FranciscoVentures/EN7745/Hardware/CHANGES.TXT

Multiple Hardware Security Elements

– NXP Semiconductors ; EdgeLock SE050 , A1006,  AT71CH 

– Infineon OPTIGA™ TRUST SLS32AIA

- Coral AI

- Microphones

- Physical Sensors
