FranciscoVentures/EN7745/Hardware/Curiosity.kicad_pcb

## KiCad design Hardware/Curiosity.kicad_pcb (2021-01-01)

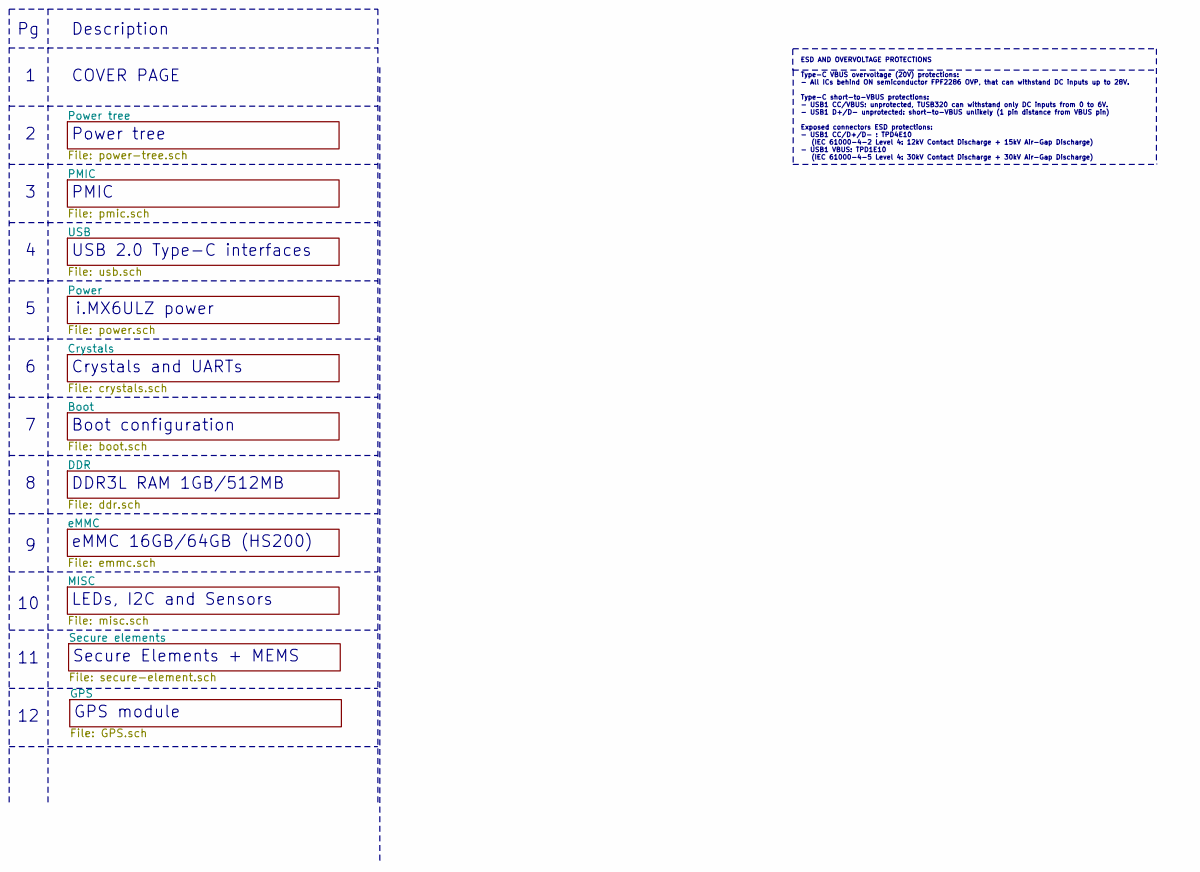
[picture p1: schematic Curiosity.sch]

Notes on the sheet:
DDR3L RAM 1GB/512MB
eMMC 16GB/64GB (HS200)
Secure Elements + MEMS
GPS module
Boot configuration
i.MX6ULZ power
USB 2.0 Type-C interfaces
Crystals and UARTs
ESD AND OVERVOLTAGE PROTECTIONS Type-C VBUS overvoltage (20V) protections: - All ICs behind ON semiconductor FPF2286 OVP, that can withstand DC inputs up to 28V. Type-C short-to-VBUS protections: - USB1 CC/VBUS: unprotected, TUSB320 can withstand only DC inputs from 0 to 6V. - USB1 D+/D- unprotecte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
PMIC
Description
Power tree
COVER PAGE
LEDs, I2C and Sensors

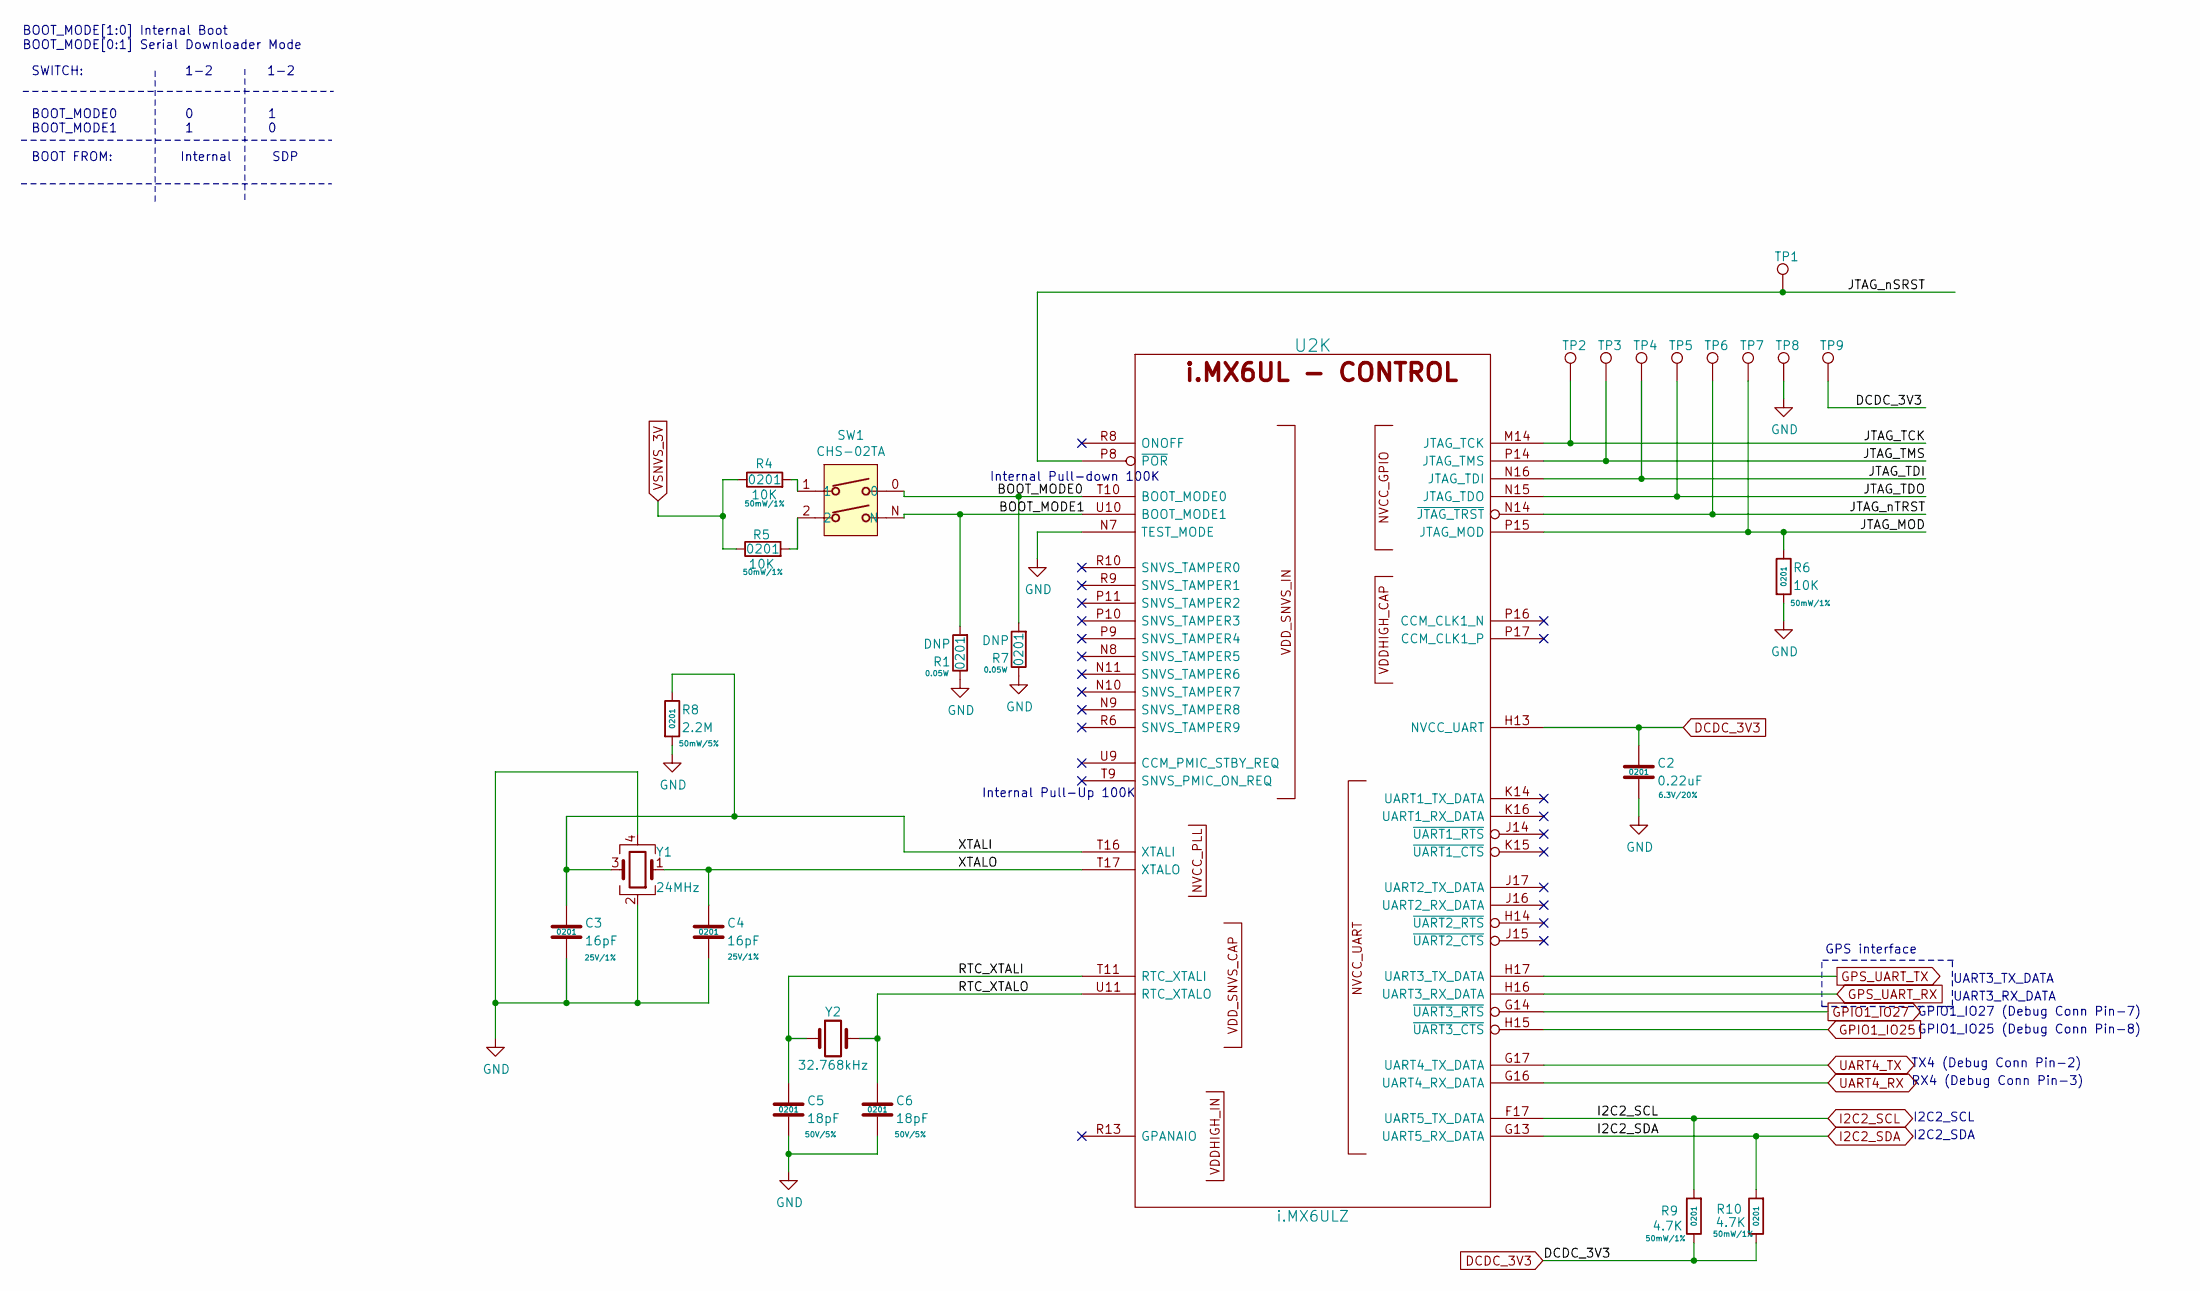
[picture p2: schematic crystals.sch]

Parts:
C2: 0.22uF; SM0201; Rating 6.3V/20%; Mfg PN GRM033R60J224ME15D; Digi-Key_PN 490-10407-1-ND
C3, C4: 16pF; SM0201; Rating 25V/1%; Mfg PN CBR02C160F3GAC; Digi-Key_PN 399-8574-1-ND
C5, C6: 18pF; SM0201; Rating 50V/5%; Mfg PN GRM0335C1H180JA01D; Digi-Key_PN 490-6117-1-ND
R1, R7: DNP; R_0201_0603Metric; Rating 0.05W; Mfg PN CRCW02010000Z0ED; Digi-Key_PN 541-0.0AGCT-ND
R4, R5, R6: 10K; R_0201_0603Metric; Rating 50mW/1%; Mfg PN CRCW020110K0JNED; Digi-Key_PN 541-10KAGCT-ND
R8: 2.2M; R_0201_0603Metric; Rating 50mW/5%; Mfg PN RC0201JR-072M2L; Digi-Key_PN YAG2882CT-ND
R9, R10: 4.7K; R_0201_0603Metric; Rating 50mW/1%; Mfg PN CRCW02014K70JNED; Digi-Key_PN 541-4.7KAGCT-ND
SW1: CHS-02TA; Mfg PN CHS-02TA; Digi-Key_PN 563-1005-2-ND
TP1, TP2, TP3, TP4, TP5, TP6, TP7, TP8, TP9: TestPoint; TP
U2: i.MX6ULZ; SOT1534-2; Mfg PN MCIMX6Z0DVM09AB; Digi-Key_PN 568-14726-ND
Y1: 24MHz; TSX-3225; Mfg PN TSX-3225 24.0000MF15X-AC3; Digi-Key_PN SER3635TR-ND
Y2: 32.768kHz; CM7V-T1A; Mfg PN CM7V-T1A-32.768KHZ-12.5PF-20PPM-TB-QA; Digi-Key_PN 2195-CM7V-T1A-32.768KHZ-12.5PF-20PPM-TB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

Connections:
/Crystals/BOOT_MODE0: R7.2, SW1.0, U2.T10 (BOOT_MODE0); also elsewhere on the board
/Crystals/BOOT_MODE1: R1.2, SW1.N, U2.U10 (BOOT_MODE1); also elsewhere on the board
/Crystals/JTAG_MOD: R6.1, TP7.1, U2.P15 (JTAG_MOD); also elsewhere on the board
/Crystals/JTAG_TCK: TP2.1, U2.M14 (JTAG_TCK); also elsewhere on the board
/Crystals/JTAG_TDI: TP4.1, U2.N16 (JTAG_TDI); also elsewhere on the board
/Crystals/JTAG_TDO: TP5.1, U2.N15 (JTAG_TDO); also elsewhere on the board
/Crystals/JTAG_TMS: TP3.1, U2.P14 (JTAG_TMS); also elsewhere on the board
/Crystals/JTAG_nSRST: TP1.1, U2.P8 (~POR); also elsewhere on the board
/Crystals/JTAG_nTRST: TP6.1, U2.N14 (~JTAG_TRST); also elsewhere on the board
/Crystals/RTC_XTALI: C5.1, U2.T11 (RTC_XTALI), Y2.1; also elsewhere on the board
/Crystals/RTC_XTALO: C6.1, U2.U11 (RTC_XTALO), Y2.2; also elsewhere on the board
/Crystals/XTALI: C3.1, R8.1, U2.T16 (XTALI), Y1.3; also elsewhere on the board
/Crystals/XTALO: C4.1, U2.T17 (XTALO), Y1.1; also elsewhere on the board
DCDC_3V3: C2.1, R9.1, R10.1, TP9.1, U2.H13 (NVCC_UART); also elsewhere on the board
GND: C2.2, C3.2, C4.2, C5.2, C6.2, R1.1, R6.2, R7.1, R8.2, TP8.1, U2.N7 (TEST_MODE), Y1.2, Y1.4; also elsewhere on the board
GPIO1_IO25: U2.H15 (~UART3_CTS); also elsewhere on the board
GPIO1_IO27: U2.G14 (~UART3_RTS); also elsewhere on the board
GPS_UART_RX: U2.H16 (UART3_RX_DATA); also elsewhere on the board
GPS_UART_TX: U2.H17 (UART3_TX_DATA); also elsewhere on the board
I2C2_SCL: R9.2, U2.F17 (UART5_TX_DATA); also elsewhere on the board
I2C2_SDA: R10.2, U2.G13 (UART5_RX_DATA); also elsewhere on the board
unnamed: R4.2, SW1.1
unnamed: R5.2, SW1.2
unnamed 209: U2.H14 (~UART2_RTS); also elsewhere on the board
unnamed 211: U2.J14 (~UART1_RTS); also elsewhere on the board
unnamed 212: U2.J15 (~UART2_CTS); also elsewhere on the board
unnamed 213: U2.J16 (UART2_RX_DATA); also elsewhere on the board
unnamed 214: U2.J17 (UART2_TX_DATA); also elsewhere on the board
unnamed 215: U2.K14 (UART1_TX_DATA); also elsewhere on the board
unnamed 216: U2.K15 (~UART1_CTS); also elsewhere on the board
unnamed 217: U2.K16 (UART1_RX_DATA); also elsewhere on the board
unnamed 218: U2.N8 (SNVS_TAMPER5); also elsewhere on the board
unnamed 219: U2.N9 (SNVS_TAMPER8); also elsewhere on the board
unnamed 220: U2.N10 (SNVS_TAMPER7); also elsewhere on the board
unnamed 221: U2.N11 (SNVS_TAMPER6); also elsewhere on the board
unnamed 222: U2.P9 (SNVS_TAMPER4); also elsewhere on the board
unnamed 223: U2.P10 (SNVS_TAMPER3); also elsewhere on the board
unnamed 224: U2.P11 (SNVS_TAMPER2); also elsewhere on the board
unnamed 225: U2.P16 (CCM_CLK1_N); also elsewhere on the board
unnamed 226: U2.P17 (CCM_CLK1_P); also elsewhere on the board
unnamed 227: U2.R6 (SNVS_TAMPER9); also elsewhere on the board
unnamed 228: U2.R8 (ONOFF); also elsewhere on the board
unnamed 229: U2.R9 (SNVS_TAMPER1); also elsewhere on the board
unnamed 230: U2.R10 (SNVS_TAMPER0); also elsewhere on the board
unnamed 231: U2.R13 (GPANAIO); also elsewhere on the board
unnamed 232: U2.T9 (SNVS_PMIC_ON_REQ); also elsewhere on the board
unnamed 234: U2.U9 (CCM_PMIC_STBY_REQ); also elsewhere on the board
UART4_RX: U2.G16 (UART4_RX_DATA); also elsewhere on the board
UART4_TX: U2.G17 (UART4_TX_DATA); also elsewhere on the board
VSNVS_3V: R4.1, R5.1; also elsewhere on the board

Notes on the sheet:
BOOT_MODE[1:0] Internal Boot BOOT_MODE[0:1] Serial Downloader Mode
GPS interface
UART3_TX_DATA
UART3_RX_DATA
SWITCH: 1-2 1-2 BOOT_MODE0 0 1 BOOT_MODE1 1 0 BOOT FROM: Internal SDP
GPIO1_IO27 (Debug Conn Pin-7)
RX4 (Debug Conn Pin-3)
TX4 (Debug Conn Pin-2)
I2C2_SDA
I2C2_SCL
Internal Pull-down 100K
Internal Pull-Up 100K
GPIO1_IO25 (Debug Conn Pin-8)

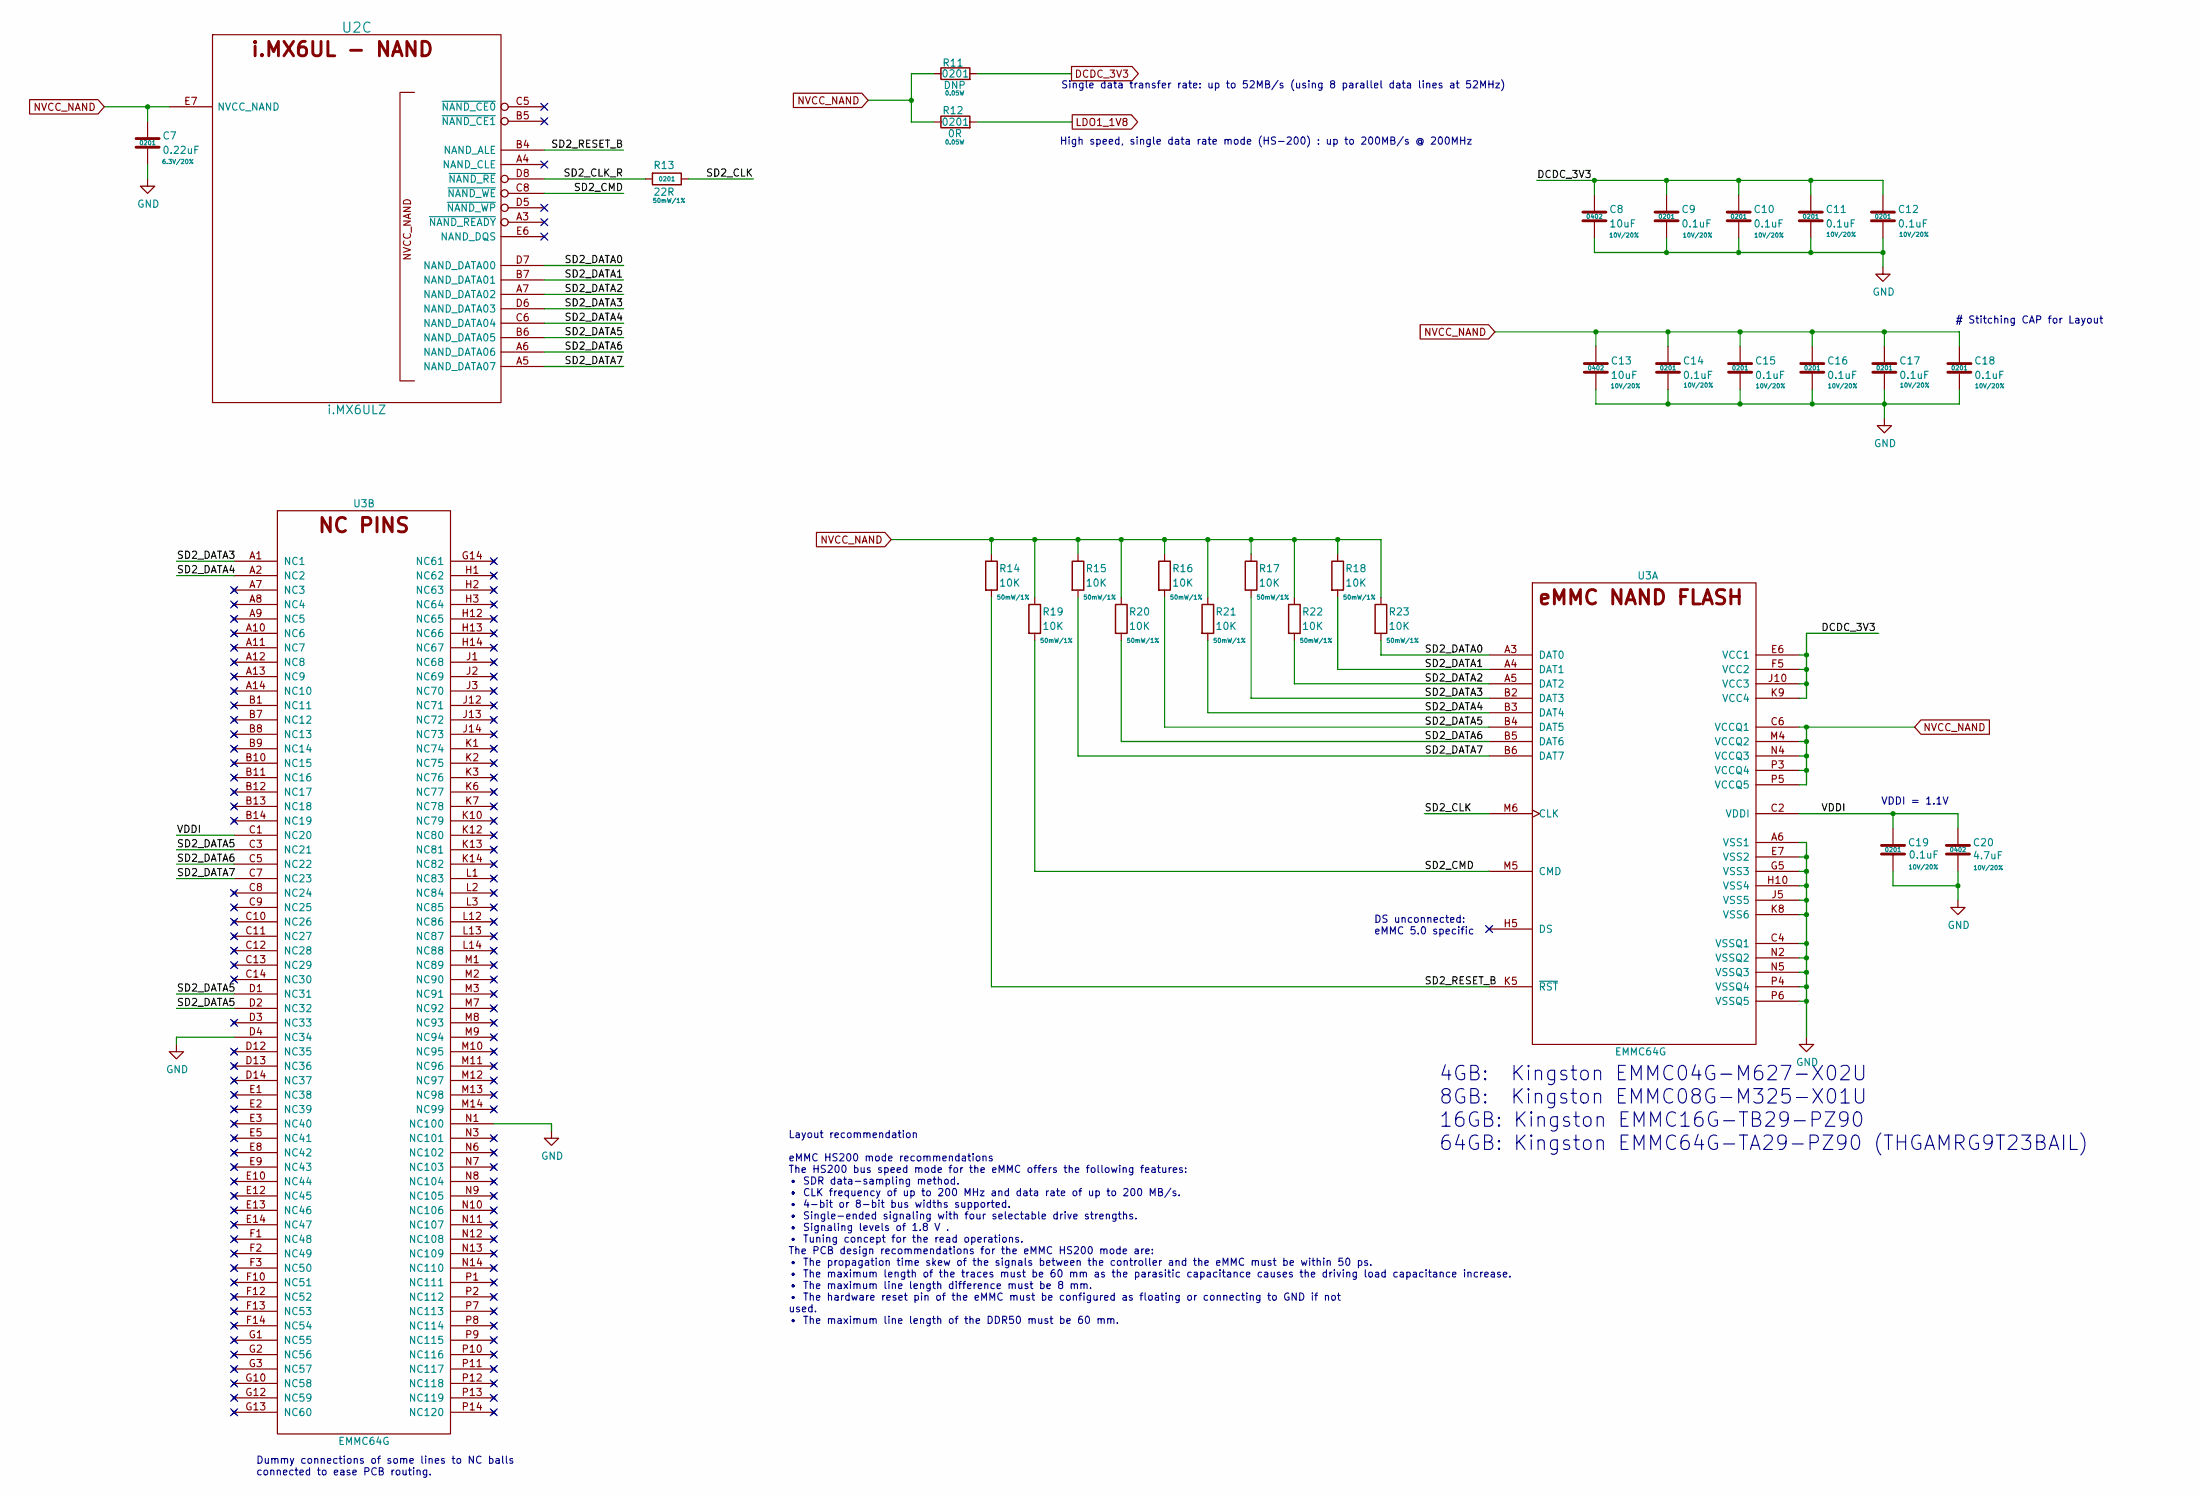
[picture p3: schematic emmc.sch]

Parts:
C7: 0.22uF; SM0201; Rating 6.3V/20%; Mfg PN GRM033R60J224ME15D; Digi-Key_PN 490-10407-1-ND
C8, C13: 10uF; SM0402; Rating 10V/20%; Mfg PN CL05A106MP8NUB8; Digi-Key_PN 1276-6830-1-ND
C9, C10, C11, C12, C14, C15, C16, C17, C18, C19: 0.1uF; SM0201; Rating 10V/20%; Mfg PN GRM033R61A104ME15D; Digi-Key_PN 490-5405-1-ND
C20: 4.7uF; SM0402; Rating 10V/20%; Mfg PN ZRB15XR61A475ME01D; Digi-Key_PN 490-10984-1-ND
R11: DNP; R_0201_0603Metric; Rating 0.05W; Mfg PN CRCW02010000Z0ED; Digi-Key_PN 541-0.0AGCT-ND
R12: 0R; R_0201_0603Metric; Rating 0.05W; Mfg PN CRCW02010000Z0ED; Digi-Key_PN 541-0.0AGCT-ND
R13: 22R; R_0201_0603Metric; Rating 50mW/1%; Mfg PN CRCW020122R0JNED; Digi-Key_PN 541-22AGCT-ND
R14, R15, R16, R17, R18, R19, R20, R21, R22, R23: 10K; R_0201_0603Metric; Rating 50mW/1%; Mfg PN CRCW020110K0JNED; Digi-Key_PN 541-10KAGCT-ND
U2: i.MX6ULZ; SOT1534-2; Mfg PN MCIMX6Z0DVM09AB; Digi-Key_PN 568-14726-ND
U3: EMMC64G; FBGA-153; Mfg PN THGAMRG9T23BAIL; Digi-Key_PN THGAMRG9T23BAIL-ND

Connections:
/eMMC/SD2_CLK: R13.1, U3.M6 (CLK)
/eMMC/SD2_CLK_R: R13.2, U2.D8 (~NAND_RE); also elsewhere on the board
/eMMC/SD2_CMD: R19.2, U2.C8 (~NAND_WE), U3.M5 (CMD); also elsewhere on the board
/eMMC/SD2_DATA0: R23.2, U2.D7 (NAND_DATA00), U3.A3 (DAT0); also elsewhere on the board
/eMMC/SD2_DATA1: R18.2, U2.B7 (NAND_DATA01), U3.A4 (DAT1); also elsewhere on the board
/eMMC/SD2_DATA2: R22.2, U2.A7 (NAND_DATA02), U3.A5 (DAT2); also elsewhere on the board
/eMMC/SD2_DATA3: R17.2, U2.D6 (NAND_DATA03), U3.A1 (NC1), U3.B2 (DAT3); also elsewhere on the board
/eMMC/SD2_DATA4: R21.2, U2.C6 (NAND_DATA04), U3.A2 (NC2), U3.B3 (DAT4); also elsewhere on the board
/eMMC/SD2_DATA5: R16.2, U2.B6 (NAND_DATA05), U3.B4 (DAT5), U3.C3 (NC21), U3.D1 (NC31), U3.D2 (NC32); also elsewhere on the board
/eMMC/SD2_DATA6: R20.2, U2.A6 (NAND_DATA06), U3.B5 (DAT6), U3.C5 (NC22); also elsewhere on the board
/eMMC/SD2_DATA7: R15.2, U2.A5 (NAND_DATA07), U3.B6 (DAT7), U3.C7 (NC23); also elsewhere on the board
/eMMC/SD2_RESET_B: R14.2, U2.B4 (NAND_ALE), U3.K5 (~RST); also elsewhere on the board
/eMMC/VDDI: C19.1, C20.1, U3.C1 (NC20), U3.C2 (VDDI)
DCDC_3V3: C8.1, C9.1, C10.1, C11.1, C12.1, R11.2, U3.E6 (VCC1), U3.F5 (VCC2), U3.J10 (VCC3), U3.K9 (VCC4); also elsewhere on the board
GND: C7.2, C8.2, C9.2, C10.2, C11.2, C12.2, C13.2, C14.2, C15.2, C16.2, C17.2, C18.2, C19.2, C20.2, U3.A6 (VSS1), U3.C4 (VSSQ1), U3.D4 (NC34), U3.E7 (VSS2), U3.G5 (VSS3), U3.H10 (VSS4), U3.J5 (VSS5), U3.K8 (VSS6), U3.N1 (NC100), U3.N2 (VSSQ2), U3.N5 (VSSQ3), U3.P4 (VSSQ4), U3.P6 (VSSQ5); also elsewhere on the board
LDO1_1V8: R12.2; also elsewhere on the board
NVCC_NAND: C7.1, C13.1, C14.1, C15.1, C16.1, C17.1, C18.1, R11.1, R12.1, R14.1, R15.1, R16.1, R17.1, R18.1, R19.1, R20.1, R21.1, R22.1, R23.1, U2.E7 (NVCC_NAND), U3.C6 (VCCQ1), U3.M4 (VCCQ2), U3.N4 (VCCQ3), U3.P3 (VCCQ4), U3.P5 (VCCQ5); also elsewhere on the board
unnamed 175: U2.A3 (~NAND_READY); also elsewhere on the board
unnamed 176: U2.A4 (NAND_CLE); also elsewhere on the board
unnamed 182: U2.B5 (~NAND_CE1); also elsewhere on the board
unnamed 187: U2.C5 (~NAND_CE0); also elsewhere on the board
unnamed 192: U2.D5 (~NAND_WP); also elsewhere on the board
unnamed 196: U2.E6 (NAND_DQS); also elsewhere on the board

Notes on the sheet:
Dummy connections of some lines to NC balls connected to ease PCB routing.
DS unconnected: eMMC 5.0 specific
4GB: Kingston EMMC04G-M627-X02U 8GB: Kingston EMMC08G-M325-X01U 16GB: Kingston EMMC16G-TB29-PZ90 64GB: Kingston EMMC64G-TA29-PZ90 (THGAMRG9T23BAIL)
# Stitching CAP for Layout
High speed, single data rate mode (HS-200) : up to 200MB/s @ 200MHz
Single data transfer rate: up to 52MB/s (using 8 parallel data lines at 52MHz)
Layout recommendation eMMC HS200 mode recommendations The HS200 bus speed mode for the eMMC offers the following features: • SDR data-sampling method. • CLK frequency of up to 200 MHz and data rate of up to 200 MB/s. • 4-bit or 8-bit bus widths supported. • Single-ended signaling with four selectab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
VDDI = 1.1V

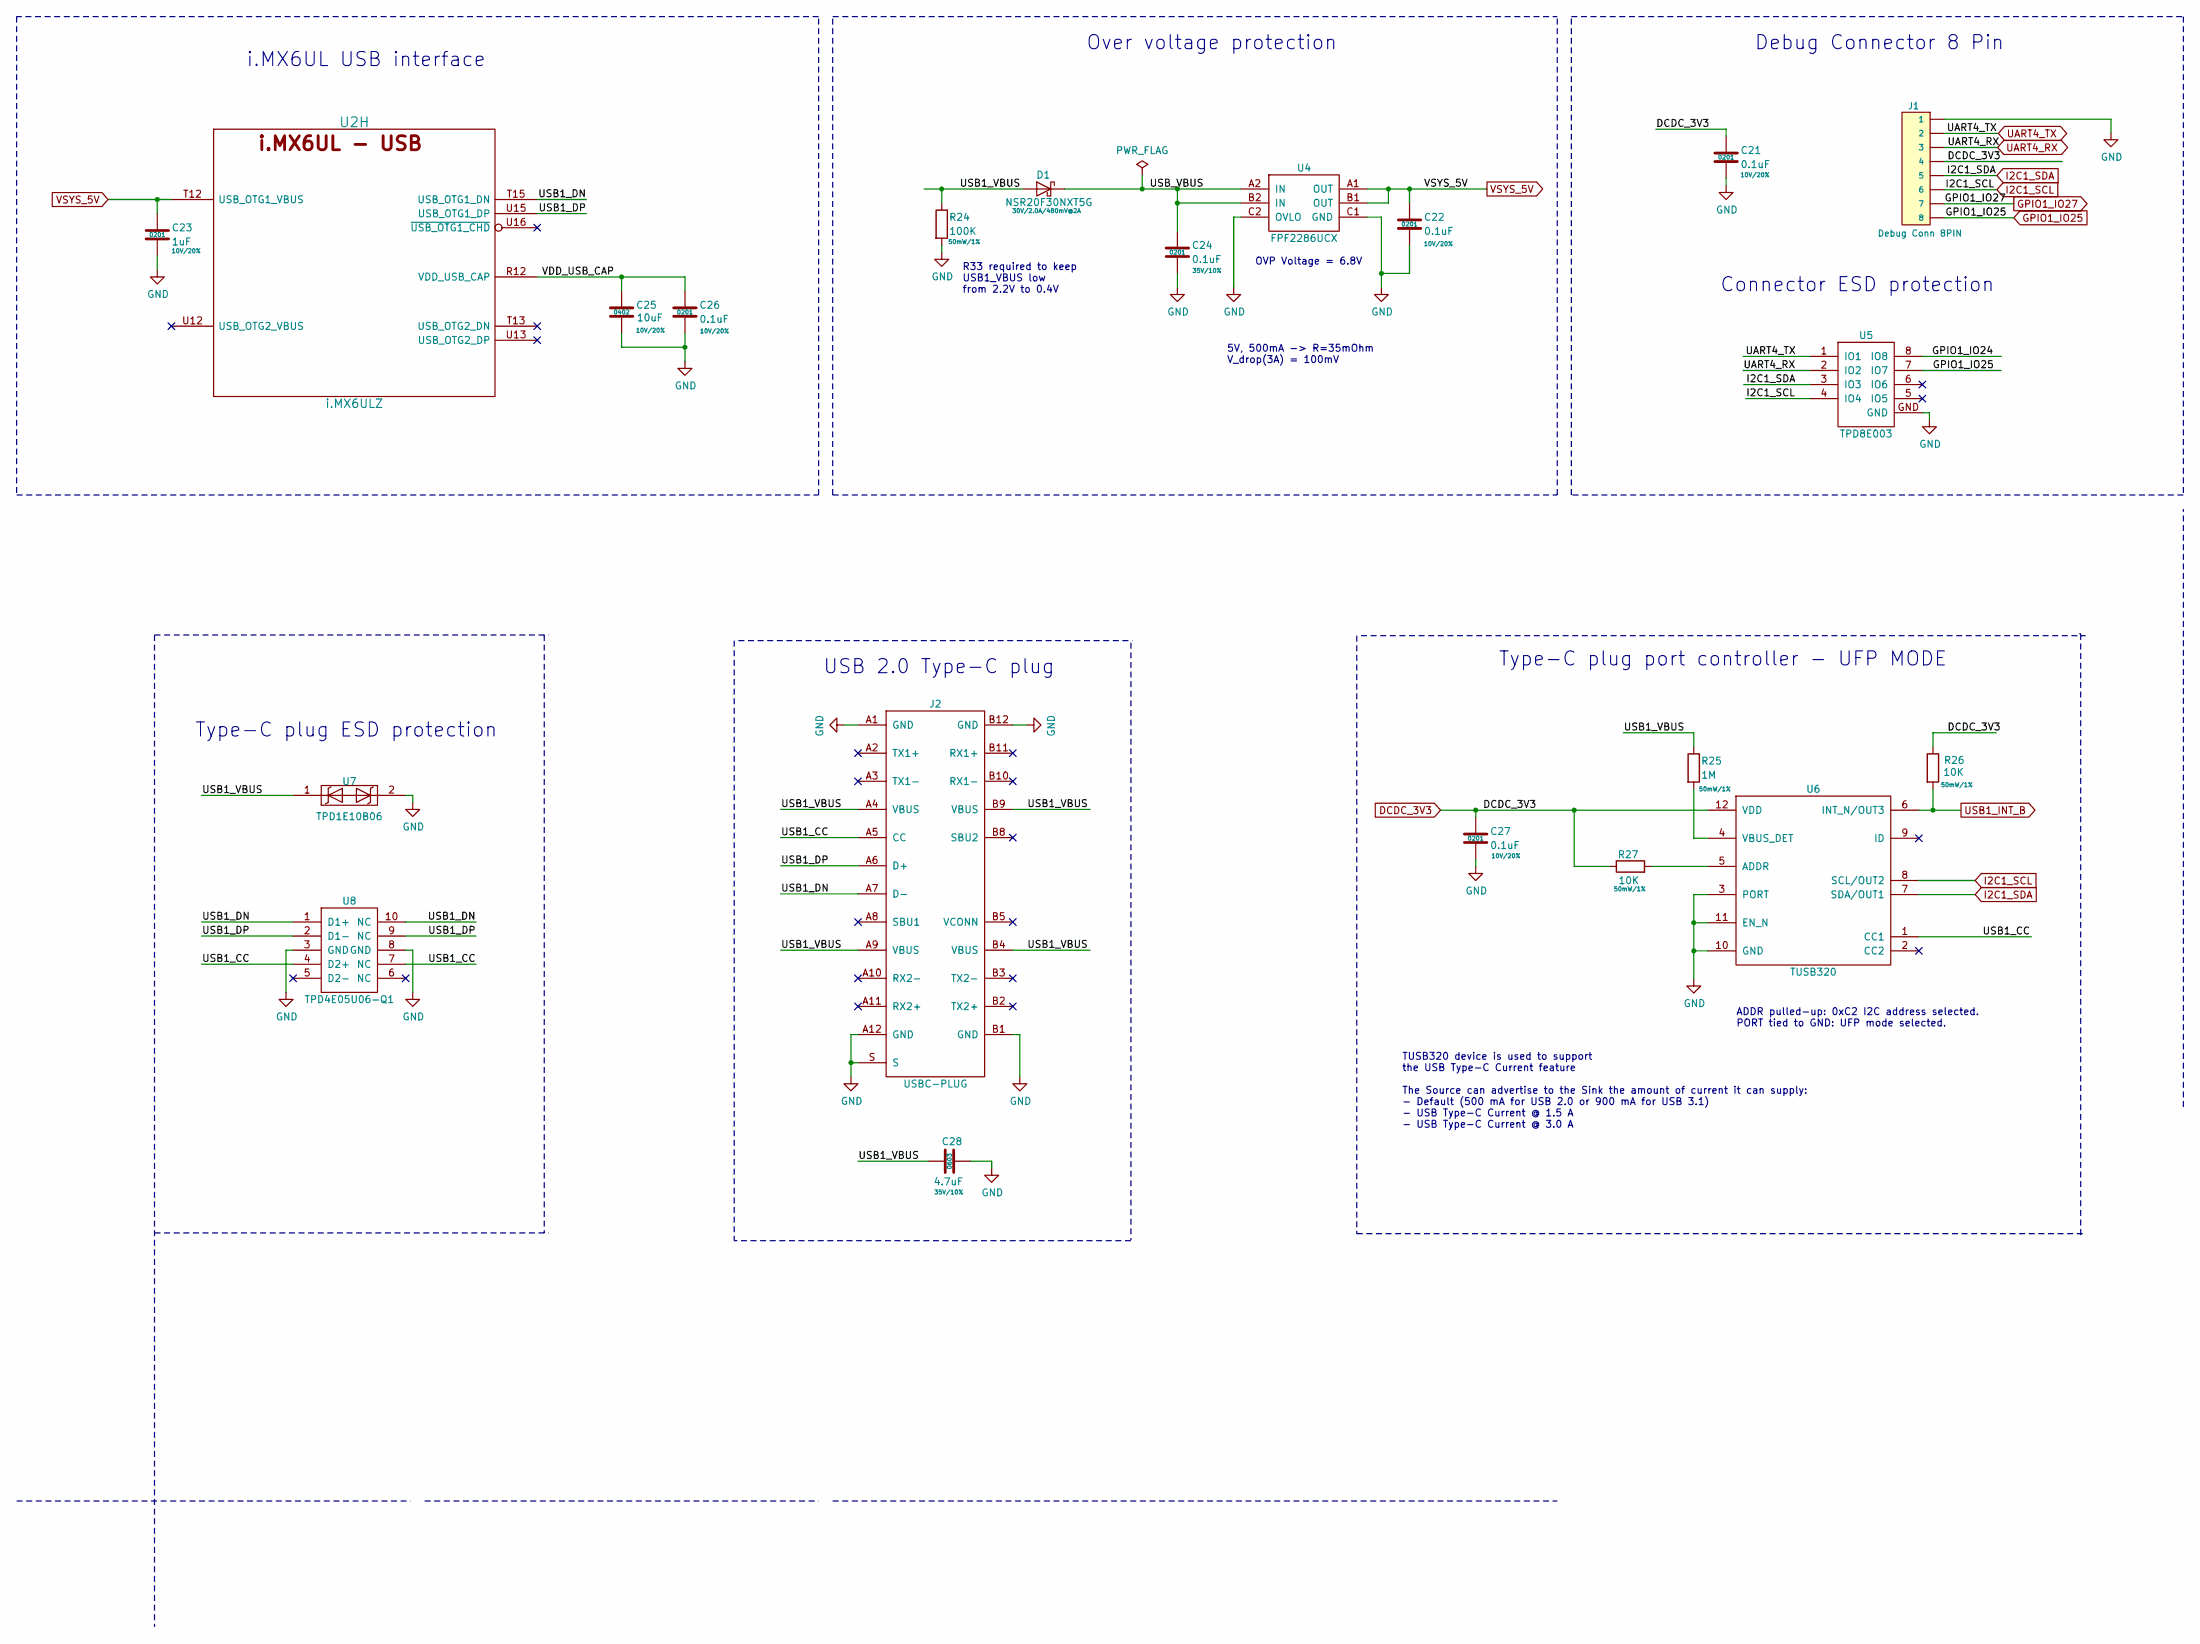
[picture p4: schematic usb.sch]

Parts:
C21, C22, C26, C27: 0.1uF; SM0201; Rating 10V/20%; Mfg PN GRM033R61A104ME15D; Digi-Key_PN 490-5405-1-ND
C23: 1uF; SM0201; Rating 10V/20%; Mfg PN CL03A105MP3ZSNH; Digi-Key_PN 1276-6816-1-ND
C24: 0.1uF; SM0201; Rating 35V/10%; Mfg PN GRM033R6YA104KE14D; Digi-Key_PN 490-10430-1-ND
C25: 10uF; SM0402; Rating 10V/20%; Mfg PN CL05A106MP8NUB8; Digi-Key_PN 1276-6830-1-ND
C28: 4.7uF; SM0603; Rating 35V/10%; Mfg PN GRM188R6YA475KE15D; Digi-Key_PN 490-7205-1-ND
D1: NSR20F30NXT5G; DSN2; Rating 30V/2.0A/480mV@2A; Mfg PN NSR20F30NXT5G; Digi-Key_PN NSR20F30NXT5GOSCT-ND
J1: Debug Conn 8PIN; BC075-08; Mfg PN BC075-08-A-L-A; Digi-Key_PN 2073-BC075-08-A-L-ACT-ND
J2: USBC-PLUG; WURTH_632712000011; Mfg PN 632712000011; Digi-Key_PN 732-9616-1-ND
R24: 100K; R_0201_0603Metric; Rating 50mW/1%; Mfg PN CRCW0201100KJNED; Digi-Key_PN 541-100KAGCT-ND
R25: 1M; R_0201_0603Metric; Rating 50mW/1%; Mfg PN CRCW02011M00FKED; Digi-Key_PN 541-1.00MAABCT-ND
R26, R27: 10K; R_0201_0603Metric; Rating 50mW/1%; Mfg PN CRCW020110K0JNED; Digi-Key_PN 541-10KAGCT-ND
U2: i.MX6ULZ; SOT1534-2; Mfg PN MCIMX6Z0DVM09AB; Digi-Key_PN 568-14726-ND
U4: FPF2286UCX; WLCSP-6; Mfg PN FPF2286UCX; Digi-Key_PN FPF2286UCXOSCT-ND
U5: TPD8E003; WSON-8; Mfg PN TPD8E003DQDR; Digi-Key_PN 296-27669-1-ND
U6: TUSB320; RWB-QFN-12; Mfg PN TUSB320IRWBR; Digi-Key_PN 296-42175-1-ND
U7: TPD1E10B06; X1SON-2; Mfg PN TPD1E10B06DPYR; Digi-Key_PN 296-30406-1-ND
U8: TPD4E05U06-Q1; DQA-USON-10; Mfg PN TPD4E05U06DQAR; Digi-Key_PN 296-35765-1-ND

Connections:
/USB/USB1_CC: J2.A5 (CC), U6.1 (CC1), U8.4 (D2+), U8.7 (NC)
/USB/USB1_DN: J2.A7 (D-), U2.T15 (USB_OTG1_DN), U8.1 (D1+), U8.10 (NC); also elsewhere on the board
/USB/USB1_DP: J2.A6 (D+), U2.U15 (USB_OTG1_DP), U8.2 (D1-), U8.9 (NC); also elsewhere on the board
/USB/USB1_VBUS: C28.1, D1.2 (A), J2.A4 (VBUS), J2.A9 (VBUS), J2.B4 (VBUS), J2.B9 (VBUS), R24.1, R25.1, U7.1
/USB/USB_VBUS: C24.1, D1.1 (K), U4.A2 (IN), U4.B2 (IN)
/USB/VDD_USB_CAP: C25.1, C26.1, U2.R12 (VDD_USB_CAP); also elsewhere on the board
DCDC_3V3: C21.1, C27.1, J1.4, R26.1, R27.1, U6.12 (VDD); also elsewhere on the board
GND: C21.2, C22.2, C23.2, C24.2, C25.2, C26.2, C27.2, C28.2, J1.1, J2.A1 (GND), J2.A12 (GND), J2.B1 (GND), J2.B12 (GND), J2.S, R24.2, U4.C1 (GND), U4.C2 (OVLO), U5.GND, U6.3 (PORT), U6.10 (GND), U6.11 (EN_N), U7.2, U8.3 (GND), U8.8 (GND); also elsewhere on the board
GPIO1_IO25: J1.8, U5.7 (IO7); also elsewhere on the board
GPIO1_IO27: J1.7; also elsewhere on the board
I2C1_SCL: J1.6, U5.4 (IO4), U6.8 (SCL/OUT2); also elsewhere on the board
I2C1_SDA: J1.5, U5.3 (IO3), U6.7 (SDA/OUT1); also elsewhere on the board
unnamed: R25.2, U6.4 (VBUS_DET)
unnamed: R27.2, U6.5 (ADDR)
unnamed 233: U2.T13 (USB_OTG2_DN); also elsewhere on the board
unnamed 235: U2.U12 (USB_OTG2_VBUS); also elsewhere on the board
unnamed 236: U2.U13 (USB_OTG2_DP); also elsewhere on the board
unnamed 237: U2.U16 (~USB_OTG1_CHD); also elsewhere on the board
UART4_RX: J1.3, U5.2 (IO2); also elsewhere on the board
UART4_TX: J1.2, U5.1 (IO1); also elsewhere on the board
USB1_INT_B: R26.2, U6.6 (INT_N/OUT3); also elsewhere on the board
VSYS_5V: C22.1, C23.1, U2.T12 (USB_OTG1_VBUS), U4.A1 (OUT), U4.B1 (OUT); also elsewhere on the board

Notes on the sheet:
ADDR pulled-up: 0xC2 I2C address selected. PORT tied to GND: UFP mode selected.
TUSB320 device is used to support the USB Type-C Current feature The Source can advertise to the Sink the amount of current it can supply: - Default (500 mA for USB 2.0 or 900 mA for USB 3.1) - USB Type-C Current @ 1.5 A - USB Type-C Current @ 3.0 A
USB 2.0 Type-C plug
Type-C plug ESD protection
Connector ESD protection
Type-C plug port controller - UFP MODE
OVP Voltage = 6.8V
5V, 500mA -> R=35mOhm V_drop(3A) = 100mV
Over voltage protection
i.MX6UL USB interface
R33 required to keep USB1_VBUS low from 2.2V to 0.4V
Debug Connector 8 Pin
