FranciscoVentures/EN7745/Hardware/Curiosity.kicad_pcb

## KiCad design Hardware/Curiosity.kicad_pcb (continued)

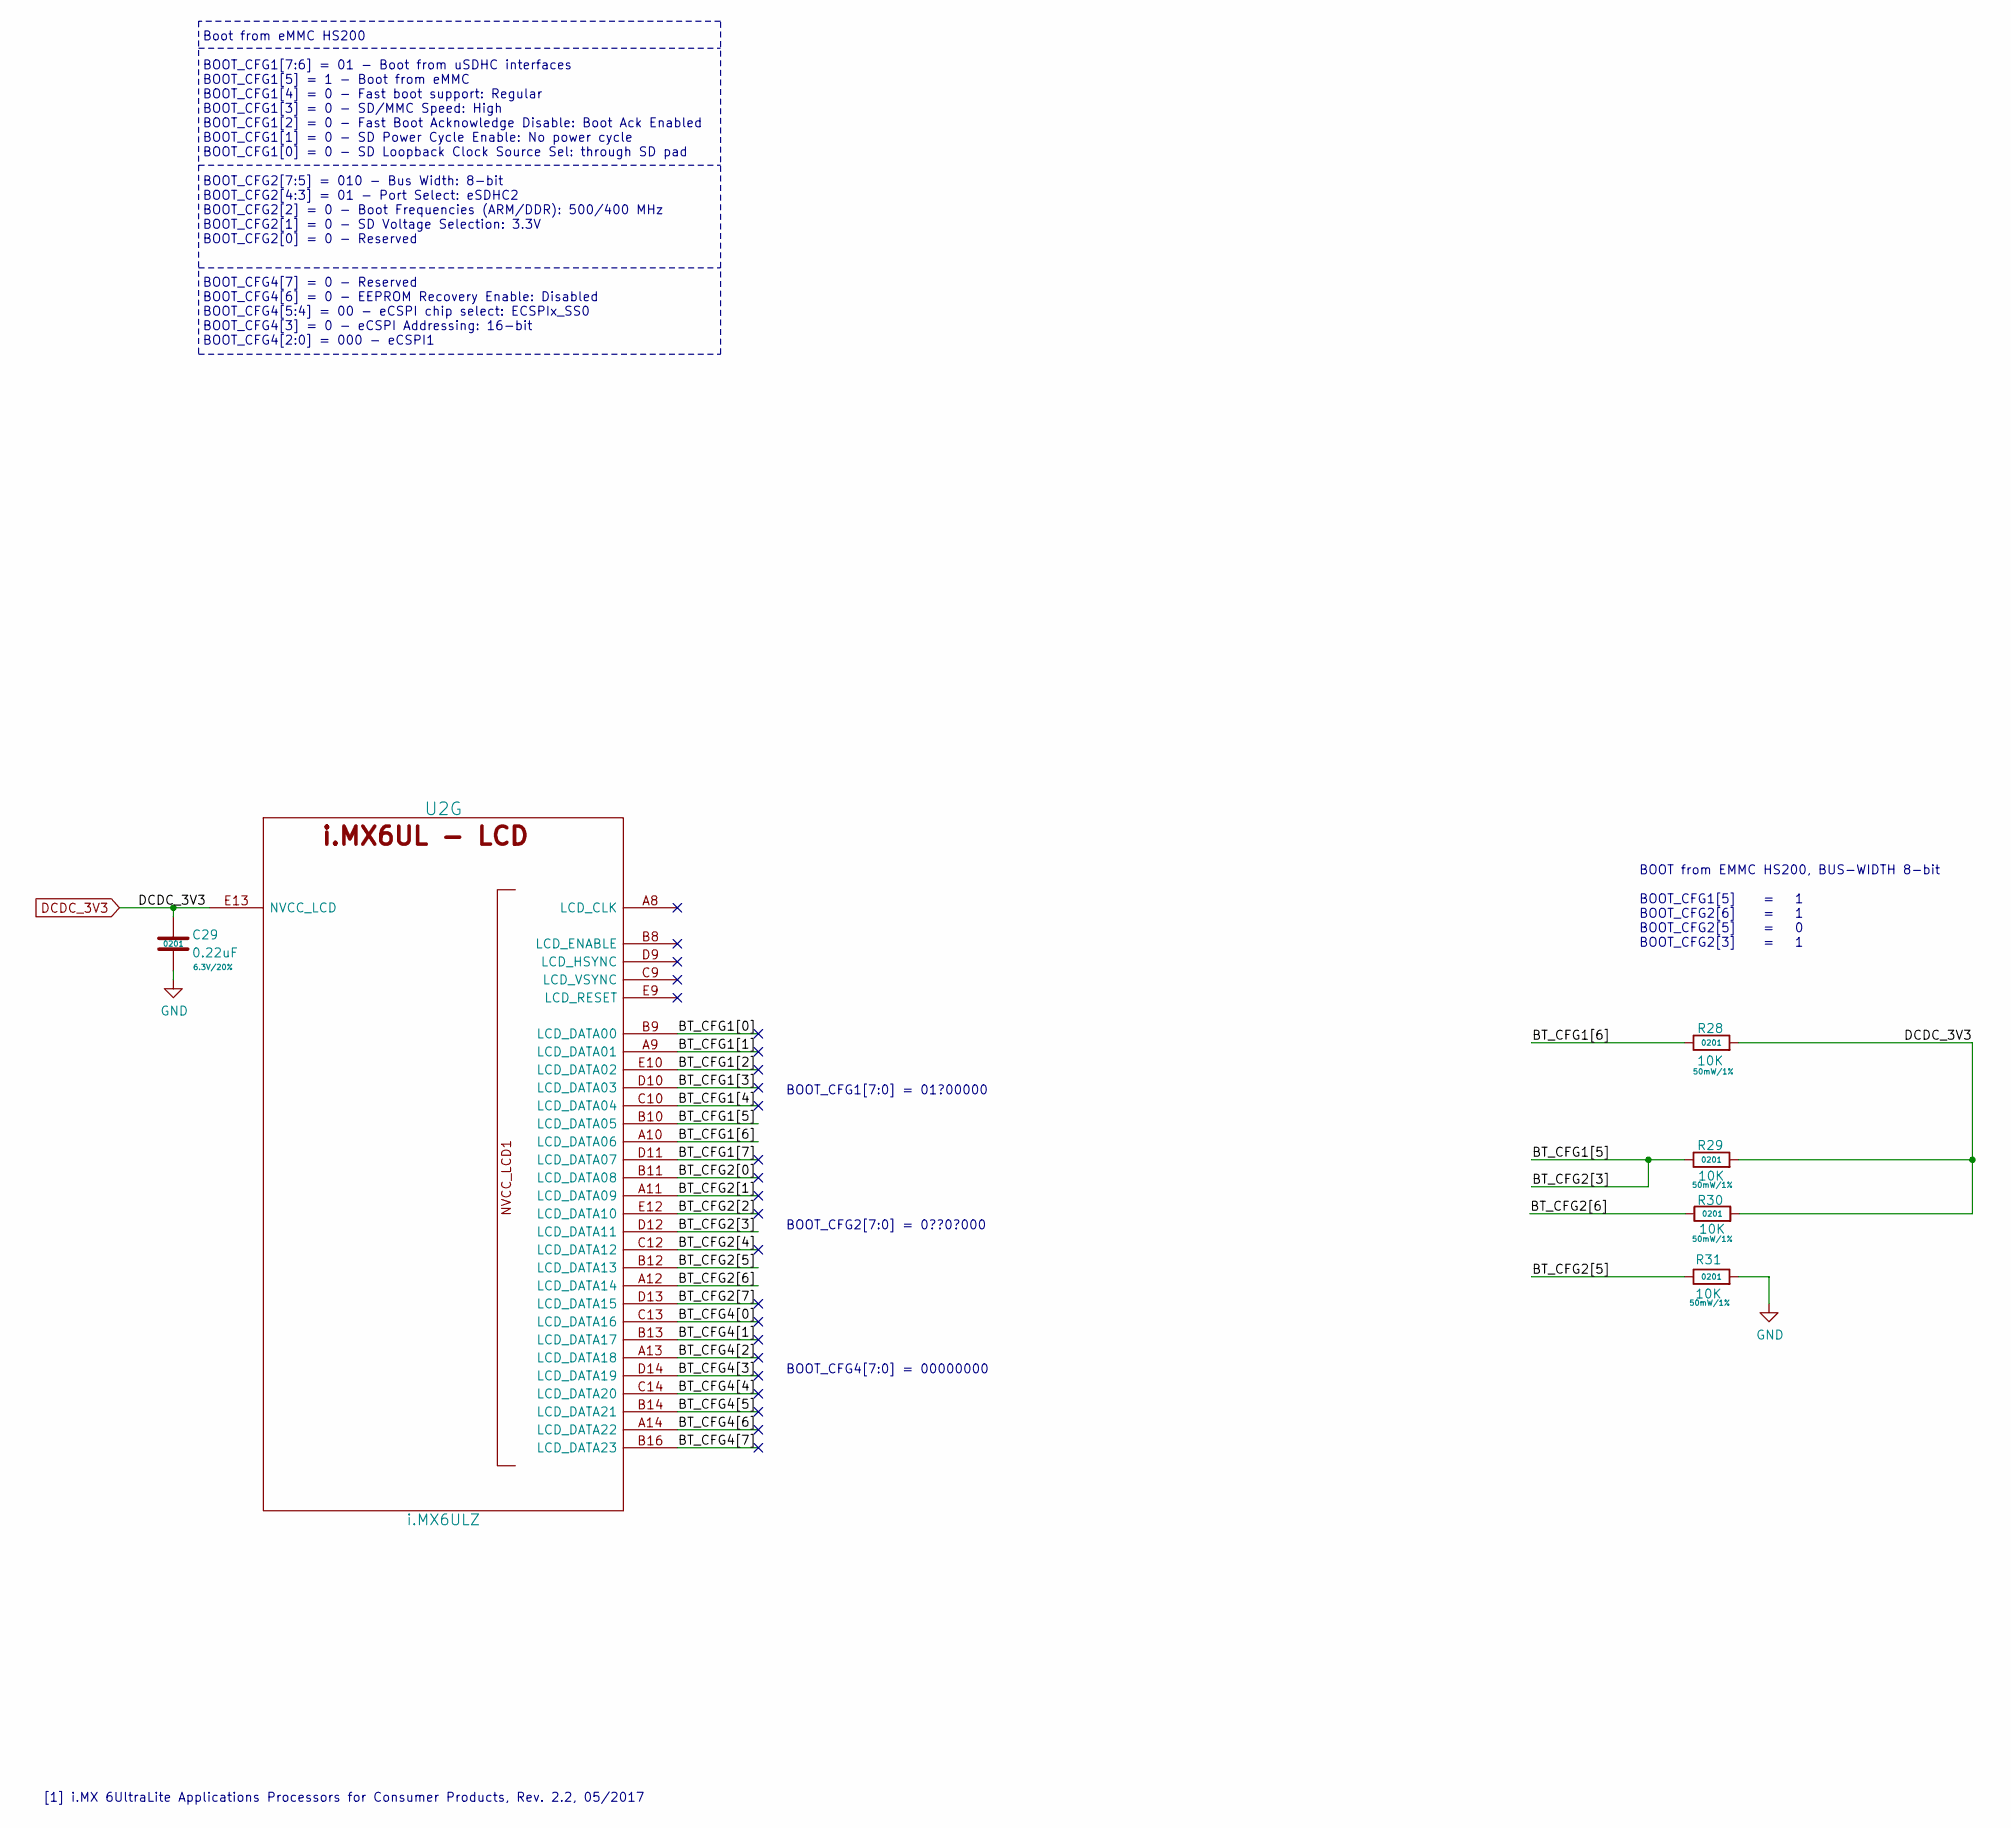
[picture p5: schematic boot.sch]

Parts:
C29: 0.22uF; SM0201; Rating 6.3V/20%; Mfg PN GRM033R60J224ME15D; Digi-Key_PN 490-10407-1-ND
R28, R29, R30, R31: 10K; R_0201_0603Metric; Rating 50mW/1%; Mfg PN CRCW020110K0JNED; Digi-Key_PN 541-10KAGCT-ND
U2: i.MX6ULZ; SOT1534-2; Mfg PN MCIMX6Z0DVM09AB; Digi-Key_PN 568-14726-ND

Connections:
/Boot/BT_CFG1[0]: U2.B9 (LCD_DATA00); also elsewhere on the board
/Boot/BT_CFG1[1]: U2.A9 (LCD_DATA01); also elsewhere on the board
/Boot/BT_CFG1[2]: U2.E10 (LCD_DATA02); also elsewhere on the board
/Boot/BT_CFG1[3]: U2.D10 (LCD_DATA03); also elsewhere on the board
/Boot/BT_CFG1[4]: U2.C10 (LCD_DATA04); also elsewhere on the board
/Boot/BT_CFG1[5]: R29.1, U2.B10 (LCD_DATA05), U2.D12 (LCD_DATA11); also elsewhere on the board
/Boot/BT_CFG1[6]: R28.1, U2.A10 (LCD_DATA06); also elsewhere on the board
/Boot/BT_CFG1[7]: U2.D11 (LCD_DATA07); also elsewhere on the board
/Boot/BT_CFG2[0]: U2.B11 (LCD_DATA08); also elsewhere on the board
/Boot/BT_CFG2[1]: U2.A11 (LCD_DATA09); also elsewhere on the board
/Boot/BT_CFG2[2]: U2.E12 (LCD_DATA10); also elsewhere on the board
/Boot/BT_CFG2[4]: U2.C12 (LCD_DATA12); also elsewhere on the board
/Boot/BT_CFG2[5]: R31.1, U2.B12 (LCD_DATA13); also elsewhere on the board
/Boot/BT_CFG2[6]: R30.1, U2.A12 (LCD_DATA14); also elsewhere on the board
/Boot/BT_CFG2[7]: U2.D13 (LCD_DATA15); also elsewhere on the board
/Boot/BT_CFG4[0]: U2.C13 (LCD_DATA16); also elsewhere on the board
/Boot/BT_CFG4[1]: U2.B13 (LCD_DATA17); also elsewhere on the board
/Boot/BT_CFG4[2]: U2.A13 (LCD_DATA18); also elsewhere on the board
/Boot/BT_CFG4[3]: U2.D14 (LCD_DATA19); also elsewhere on the board
/Boot/BT_CFG4[4]: U2.C14 (LCD_DATA20); also elsewhere on the board
/Boot/BT_CFG4[5]: U2.B14 (LCD_DATA21); also elsewhere on the board
/Boot/BT_CFG4[6]: U2.A14 (LCD_DATA22); also elsewhere on the board
/Boot/BT_CFG4[7]: U2.B16 (LCD_DATA23); also elsewhere on the board
DCDC_3V3: C29.1, R28.2, R29.2, R30.2, U2.E13 (NVCC_LCD); also elsewhere on the board
GND: C29.2, R31.2; also elsewhere on the board
unnamed 177: U2.A8 (LCD_CLK); also elsewhere on the board
unnamed 183: U2.B8 (LCD_ENABLE); also elsewhere on the board
unnamed 188: U2.C9 (LCD_VSYNC); also elsewhere on the board
unnamed 193: U2.D9 (LCD_HSYNC); also elsewhere on the board
unnamed 197: U2.E9 (LCD_RESET); also elsewhere on the board

Notes on the sheet:
Boot from eMMC HS200 BOOT_CFG1[7:6] = 01 - Boot from uSDHC interfaces BOOT_CFG1[5] = 1 - Boot from eMMC BOOT_CFG1[4] = 0 - Fast boot support: Regular BOOT_CFG1[3] = 0 - SD/MMC Speed: High BOOT_CFG1[2] = 0 - Fast Boot Acknowledge Disable: Boot Ack Enabled BOOT_CFG1[1] = 0 - SD Power Cycle Enable: No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
BOOT_CFG4[7:0] = 00000000
BOOT from EMMC HS200, BUS-WIDTH 8-bit BOOT_CFG1[5] = 1 BOOT_CFG2[6] = 1 BOOT_CFG2[5] = 0 BOOT_CFG2[3] = 1
BOOT_CFG2[7:0] = 0??0?000
BOOT_CFG1[7:0] = 01?00000
[1] i.MX 6UltraLite Applications Processors for Consumer Products, Rev. 2.2, 05/2017

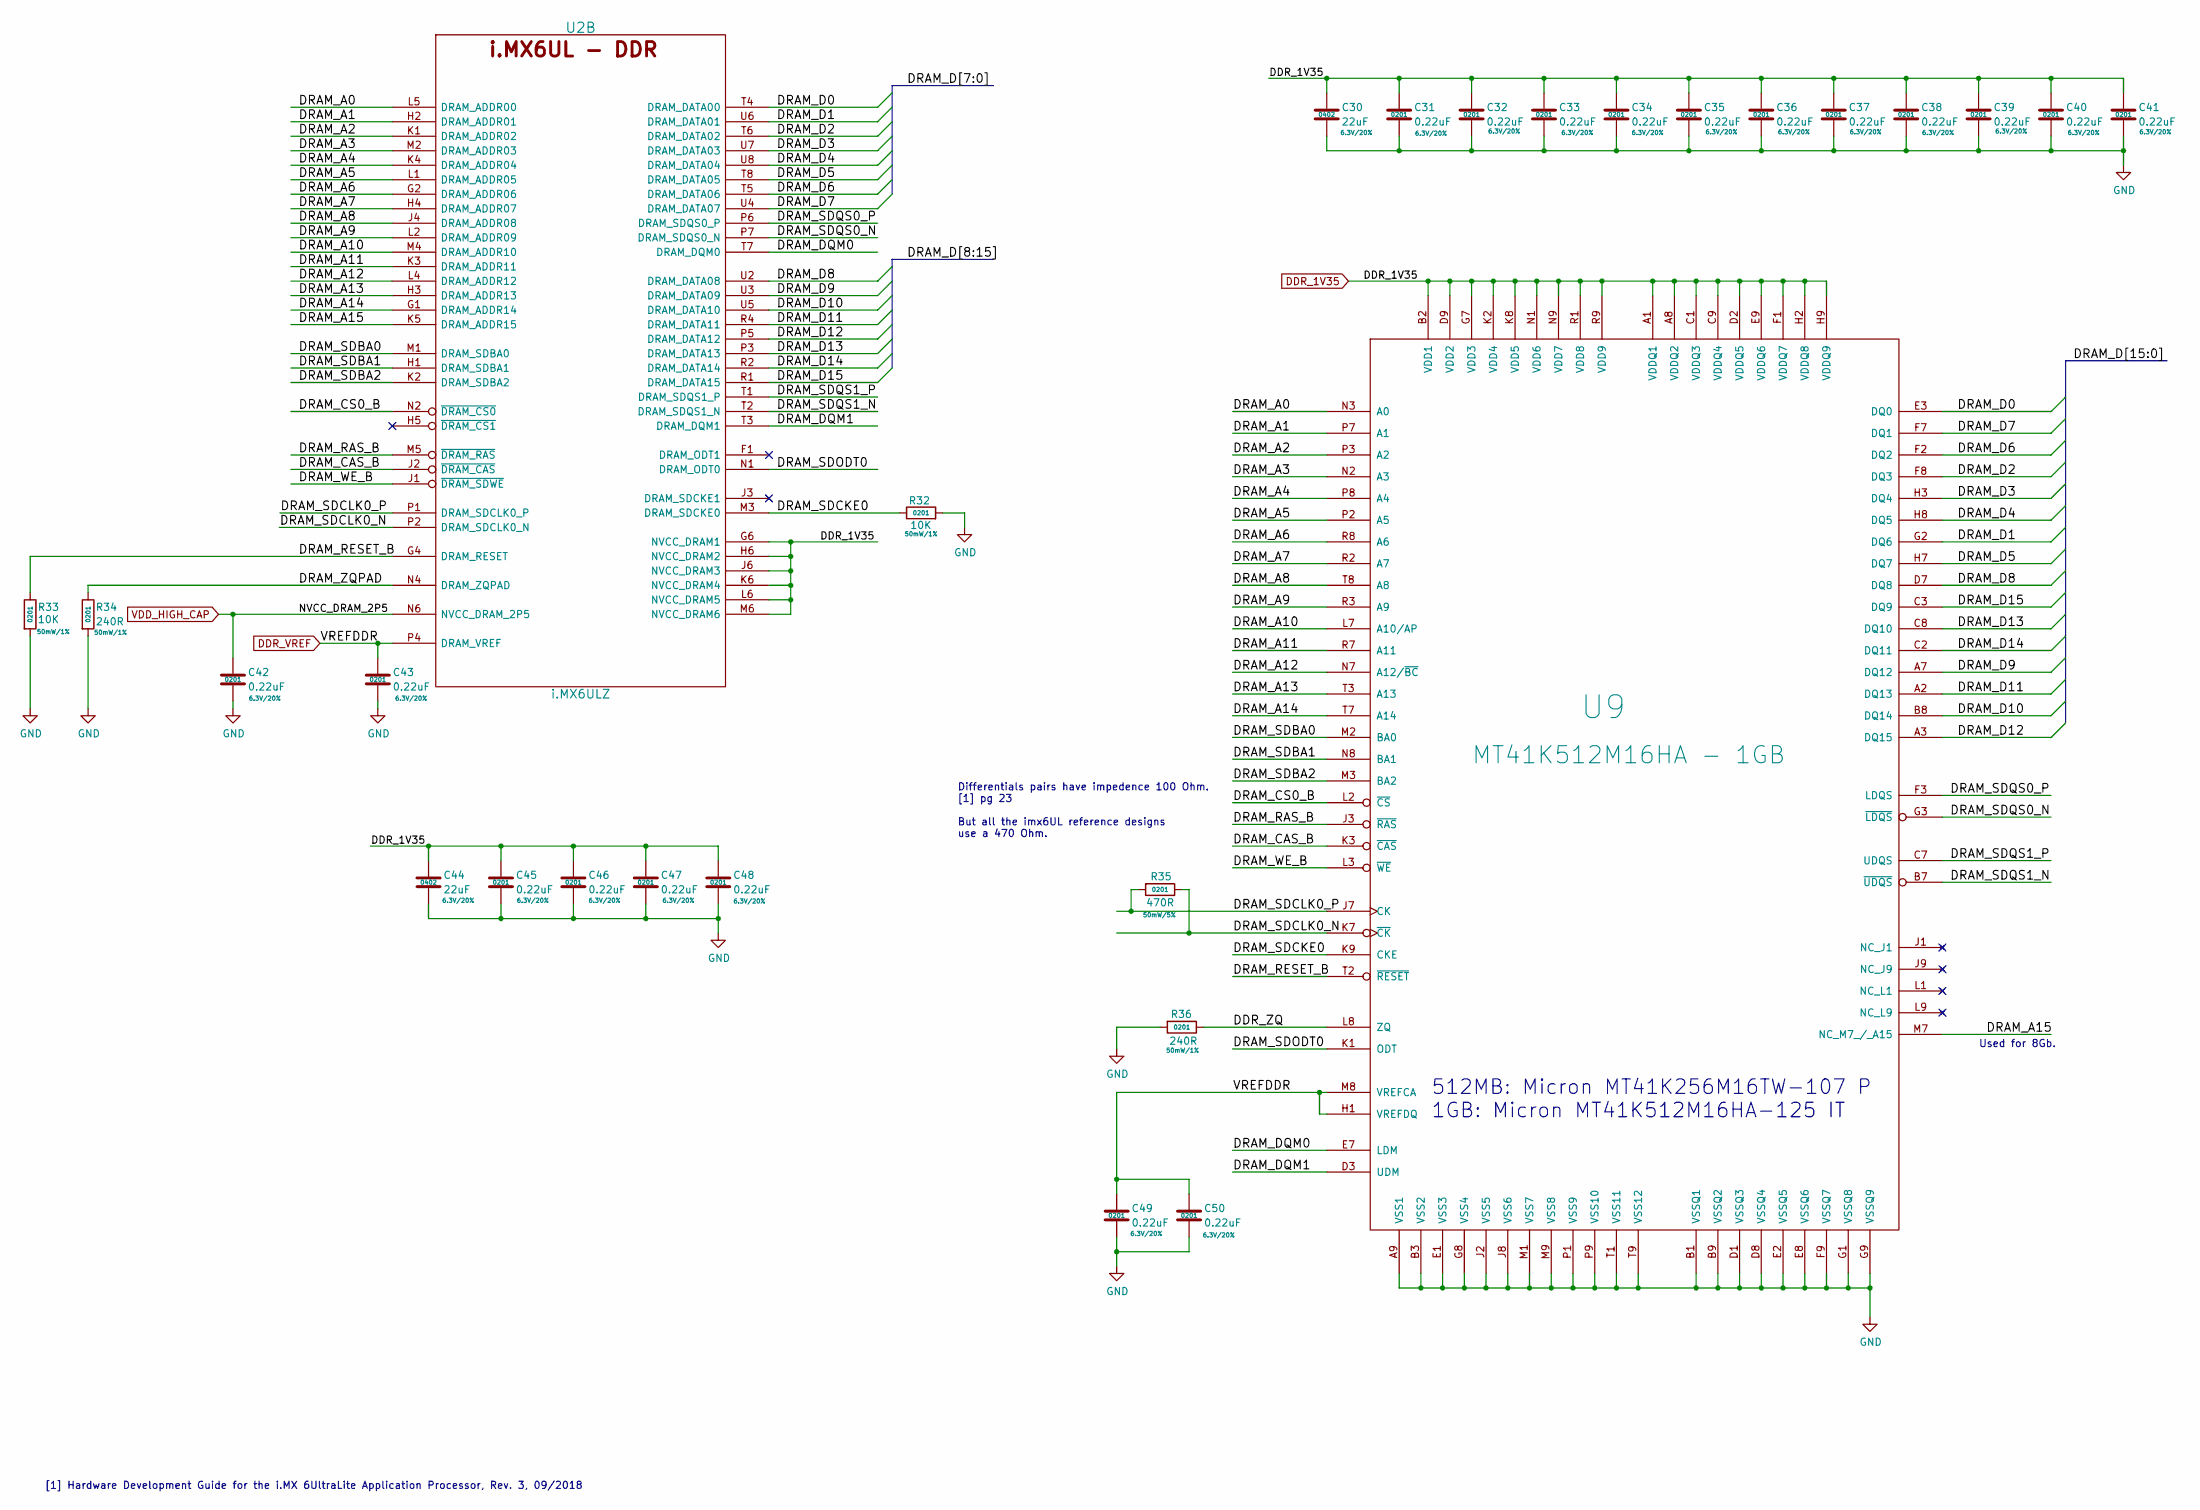
[picture p6: schematic ddr.sch]

Parts:
C30, C44: 22uF; SM0402; Rating 6.3V/20%; Mfg PN CL05A226MQ5N6J8; Digi-Key_PN 1276-7090-1-ND
C31, C32, C33, C34, C35, C36, C37, C38, C39, C40, C41, C42, C43, C45, C46, C47, C48, C49, C50: 0.22uF; SM0201; Rating 6.3V/20%; Mfg PN GRM033R60J224ME15D; Digi-Key_PN 490-10407-1-ND
R32, R33: 10K; R_0201_0603Metric; Rating 50mW/1%; Mfg PN CRCW020110K0JNED; Digi-Key_PN 541-10KAGCT-ND
R34, R36: 240R; R_0201_0603Metric; Rating 50mW/1%; Mfg PN CRCW0201240RFNED; Digi-Key_PN 541-2949-1-ND
R35: 470R; R_0201_0603Metric; Rating 50mW/5%; Mfg PN CRCW0201470RJNED; Digi-Key_PN 541-470AGCT-ND
U2: i.MX6ULZ; SOT1534-2; Mfg PN MCIMX6Z0DVM09AB; Digi-Key_PN 568-14726-ND
U9: MT41K512M16HA - 1GB; MICRON-FBGA-96; Mfg PN MT41K512M16HA-125 IT:A; Digi-Key_PN MT41K512M16HA-125IT:A-ND

Connections:
/DDR/DDR_ZQ: R36.1, U9.L8 (ZQ)
/DDR/DRAM_A0: U2.L5 (DRAM_ADDR00), U9.N3 (A0); also elsewhere on the board
/DDR/DRAM_A1: U2.H2 (DRAM_ADDR01), U9.P7 (A1); also elsewhere on the board
/DDR/DRAM_A2: U2.K1 (DRAM_ADDR02), U9.P3 (A2); also elsewhere on the board
/DDR/DRAM_A3: U2.M2 (DRAM_ADDR03), U9.N2 (A3); also elsewhere on the board
/DDR/DRAM_A4: U2.K4 (DRAM_ADDR04), U9.P8 (A4); also elsewhere on the board
/DDR/DRAM_A5: U2.L1 (DRAM_ADDR05), U9.P2 (A5); also elsewhere on the board
/DDR/DRAM_A6: U2.G2 (DRAM_ADDR06), U9.R8 (A6); also elsewhere on the board
/DDR/DRAM_A7: U2.H4 (DRAM_ADDR07), U9.R2 (A7); also elsewhere on the board
/DDR/DRAM_A8: U2.J4 (DRAM_ADDR08), U9.T8 (A8); also elsewhere on the board
/DDR/DRAM_A9: U2.L2 (DRAM_ADDR09), U9.R3 (A9); also elsewhere on the board
/DDR/DRAM_A10: U2.M4 (DRAM_ADDR10), U9.L7 (A10/AP); also elsewhere on the board
/DDR/DRAM_A11: U2.K3 (DRAM_ADDR11), U9.R7 (A11); also elsewhere on the board
/DDR/DRAM_A12: U2.L4 (DRAM_ADDR12), U9.N7 (A12/~BC); also elsewhere on the board
/DDR/DRAM_A13: U2.H3 (DRAM_ADDR13), U9.T3 (A13); also elsewhere on the board
/DDR/DRAM_A14: U2.G1 (DRAM_ADDR14), U9.T7 (A14); also elsewhere on the board
/DDR/DRAM_A15: U2.K5 (DRAM_ADDR15), U9.M7 (NC_M7_/_A15); also elsewhere on the board
/DDR/DRAM_CAS_B: U2.J2 (~DRAM_CAS), U9.K3 (~CAS); also elsewhere on the board
/DDR/DRAM_CS0_B: U2.N2 (~DRAM_CS0), U9.L2 (~CS); also elsewhere on the board
/DDR/DRAM_D0: U2.T4 (DRAM_DATA00), U9.E3 (DQ0); also elsewhere on the board
/DDR/DRAM_D1: U2.U6 (DRAM_DATA01), U9.G2 (DQ6); also elsewhere on the board
/DDR/DRAM_D2: U2.T6 (DRAM_DATA02), U9.F8 (DQ3); also elsewhere on the board
/DDR/DRAM_D3: U2.U7 (DRAM_DATA03), U9.H3 (DQ4); also elsewhere on the board
/DDR/DRAM_D4: U2.U8 (DRAM_DATA04), U9.H8 (DQ5); also elsewhere on the board
/DDR/DRAM_D5: U2.T8 (DRAM_DATA05), U9.H7 (DQ7); also elsewhere on the board
/DDR/DRAM_D6: U2.T5 (DRAM_DATA06), U9.F2 (DQ2); also elsewhere on the board
/DDR/DRAM_D7: U2.U4 (DRAM_DATA07), U9.F7 (DQ1); also elsewhere on the board
/DDR/DRAM_D8: U2.U2 (DRAM_DATA08), U9.D7 (DQ8); also elsewhere on the board
/DDR/DRAM_D9: U2.U3 (DRAM_DATA09), U9.A7 (DQ12); also elsewhere on the board
/DDR/DRAM_D10: U2.U5 (DRAM_DATA10), U9.B8 (DQ14); also elsewhere on the board
/DDR/DRAM_D11: U2.R4 (DRAM_DATA11), U9.A2 (DQ13); also elsewhere on the board
/DDR/DRAM_D12: U2.P5 (DRAM_DATA12), U9.A3 (DQ15); also elsewhere on the board
/DDR/DRAM_D13: U2.P3 (DRAM_DATA13), U9.C8 (DQ10); also elsewhere on the board
/DDR/DRAM_D14: U2.R2 (DRAM_DATA14), U9.C2 (DQ11); also elsewhere on the board
/DDR/DRAM_D15: U2.R1 (DRAM_DATA15), U9.C3 (DQ9); also elsewhere on the board
/DDR/DRAM_DQM0: U2.T7 (DRAM_DQM0), U9.E7 (LDM); also elsewhere on the board
/DDR/DRAM_DQM1: U2.T3 (DRAM_DQM1), U9.D3 (UDM); also elsewhere on the board
/DDR/DRAM_RAS_B: U2.M5 (~DRAM_RAS), U9.J3 (~RAS); also elsewhere on the board
/DDR/DRAM_RESET_B: R33.1, U2.G4 (DRAM_RESET), U9.T2 (~RESET); also elsewhere on the board
/DDR/DRAM_SDBA0: U2.M1 (DRAM_SDBA0), U9.M2 (BA0); also elsewhere on the board
/DDR/DRAM_SDBA1: U2.H1 (DRAM_SDBA1), U9.N8 (BA1); also elsewhere on the board
/DDR/DRAM_SDBA2: U2.K2 (DRAM_SDBA2), U9.M3 (BA2); also elsewhere on the board
/DDR/DRAM_SDCKE0: R32.1, U2.M3 (DRAM_SDCKE0), U9.K9 (CKE); also elsewhere on the board
/DDR/DRAM_SDCLK0_N: R35.1, U2.P2 (DRAM_SDCLK0_N), U9.K7 (~CK); also elsewhere on the board
/DDR/DRAM_SDCLK0_P: R35.2, U2.P1 (DRAM_SDCLK0_P), U9.J7 (CK); also elsewhere on the board
/DDR/DRAM_SDODT0: U2.N1 (DRAM_ODT0), U9.K1 (ODT); also elsewhere on the board
/DDR/DRAM_SDQS0_N: U2.P7 (DRAM_SDQS0_N), U9.G3 (~LDQS); also elsewhere on the board
/DDR/DRAM_SDQS0_P: U2.P6 (DRAM_SDQS0_P), U9.F3 (LDQS); also elsewhere on the board
/DDR/DRAM_SDQS1_N: U2.T2 (DRAM_SDQS1_N), U9.B7 (~UDQS); also elsewhere on the board
/DDR/DRAM_SDQS1_P: U2.T1 (DRAM_SDQS1_P), U9.C7 (UDQS); also elsewhere on the board
/DDR/DRAM_WE_B: U2.J1 (~DRAM_SDWE), U9.L3 (~WE); also elsewhere on the board
/DDR/DRAM_ZQPAD: R34.1, U2.N4 (DRAM_ZQPAD); also elsewhere on the board
DDR_1V35: C30.1, C31.1, C32.1, C33.1, C34.1, C35.1, C36.1, C37.1, C38.1, C39.1, C40.1, C41.1, C44.1, C45.1, C46.1, C47.1, C48.1, U2.G6 (NVCC_DRAM1), U2.H6 (NVCC_DRAM2), U2.J6 (NVCC_DRAM3), U2.K6 (NVCC_DRAM4), U2.L6 (NVCC_DRAM5), U2.M6 (NVCC_DRAM6), U9.A1 (VDDQ1), U9.A8 (VDDQ2), U9.B2 (VDD1), U9.C1 (VDDQ3), U9.C9 (VDDQ4), U9.D2 (VDDQ5), U9.D9 (VDD2), U9.E9 (VDDQ6), U9.F1 (VDDQ7), U9.G7 (VDD3), U9.H2 (VDDQ8), U9.H9 (VDDQ9), U9.K2 (VDD4), U9.K8 (VDD5), U9.N1 (VDD6), U9.N9 (VDD7), U9.R1 (VDD8), U9.R9 (VDD9); also elsewhere on the board
DDR_VREF: C43.1, C49.1, C50.1, U2.P4 (DRAM_VREF), U9.H1 (VREFDQ), U9.M8 (VREFCA); also elsewhere on the board
GND: C30.2, C31.2, C32.2, C33.2, C34.2, C35.2, C36.2, C37.2, C38.2, C39.2, C40.2, C41.2, C42.2, C43.2, C44.2, C45.2, C46.2, C47.2, C48.2, C49.2, C50.2, R32.2, R33.2, R34.2, R36.2, U9.A9 (VSS1), U9.B1 (VSSQ1), U9.B3 (VSS2), U9.B9 (VSSQ2), U9.D1 (VSSQ3), U9.D8 (VSSQ4), U9.E1 (VSS3), U9.E2 (VSSQ5), U9.E8 (VSSQ6), U9.F9 (VSSQ7), U9.G1 (VSSQ8), U9.G8 (VSS4), U9.G9 (VSSQ9), U9.J2 (VSS5), U9.J8 (VSS6), U9.M1 (VSS7), U9.M9 (VSS8), U9.P1 (VSS9), U9.P9 (VSS10), U9.T1 (VSS11), U9.T9 (VSS12); also elsewhere on the board
unnamed 202: U2.F1 (DRAM_ODT1); also elsewhere on the board
unnamed 208: U2.H5 (~DRAM_CS1); also elsewhere on the board
unnamed 210: U2.J3 (DRAM_SDCKE1); also elsewhere on the board
VDD_HIGH_CAP: C42.1, U2.N6 (NVCC_DRAM_2P5); also elsewhere on the board

Notes on the sheet:
Used for 8Gb.
512MB: Micron MT41K256M16TW-107 P 1GB: Micron MT41K512M16HA-125 IT
[1] Hardware Development Guide for the i.MX 6UltraLite Application Processor, Rev. 3, 09/2018
Differentials pairs have impedence 100 Ohm. [1] pg 23 But all the imx6UL reference designs use a 470 Ohm.

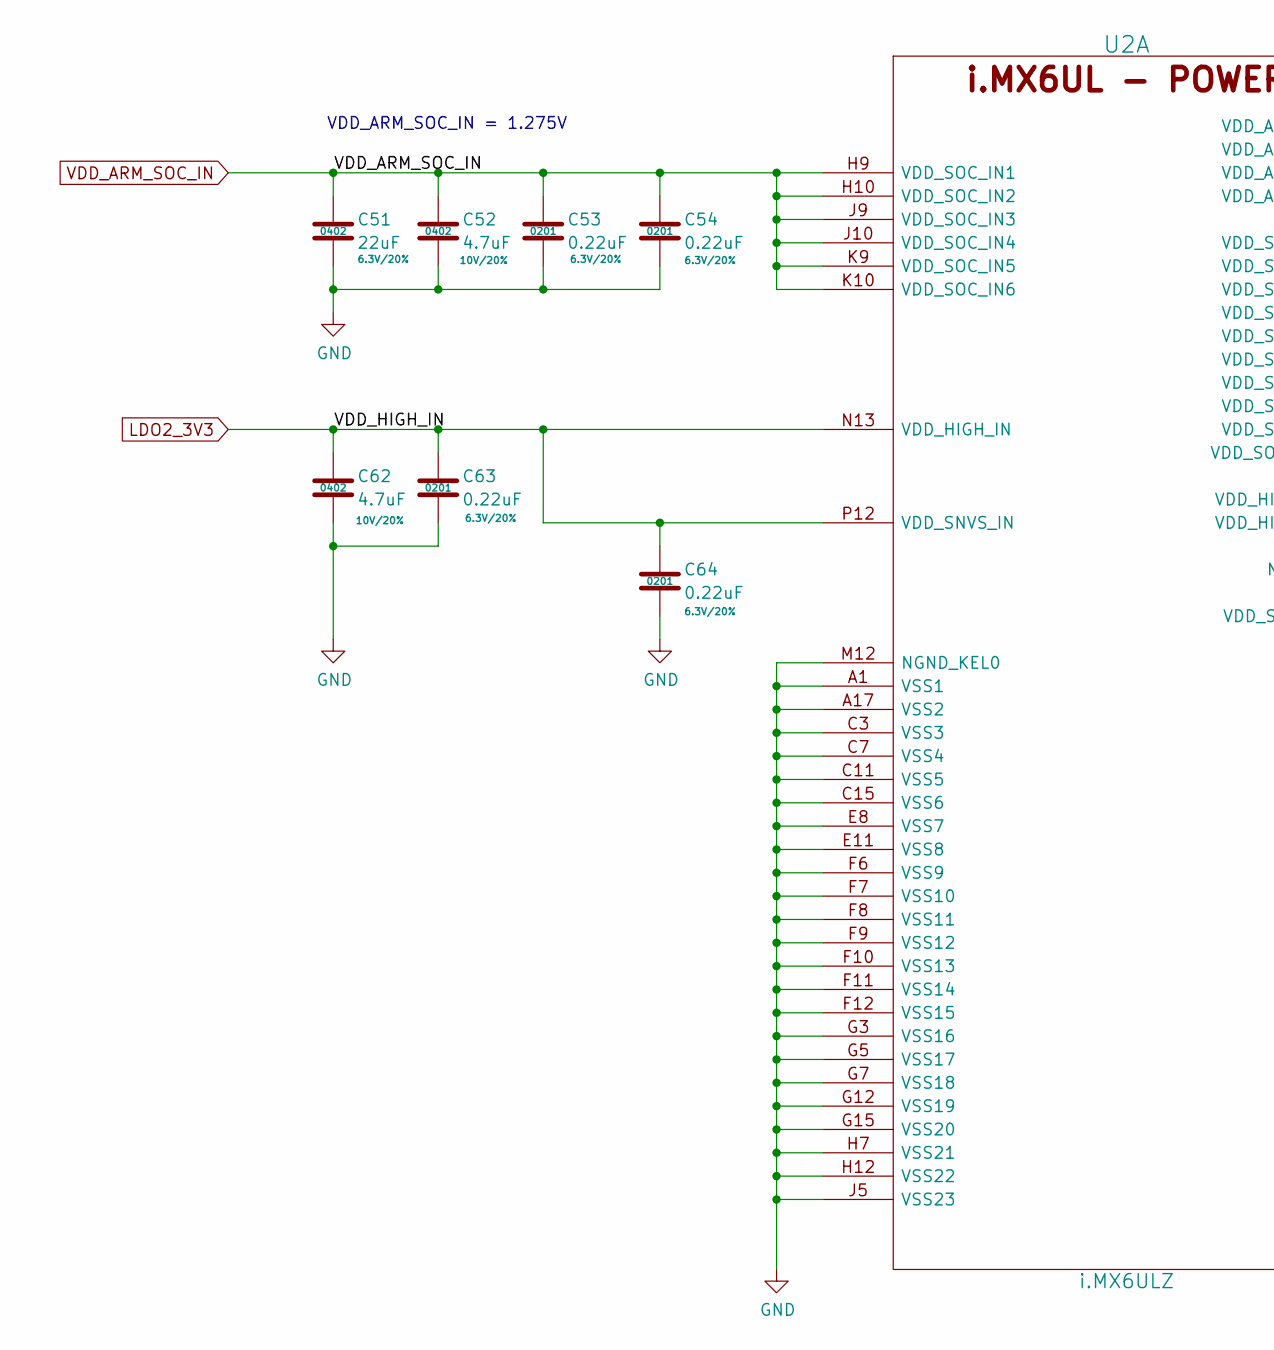
[picture p7: schematic power.sch, part in row 1, column 1]

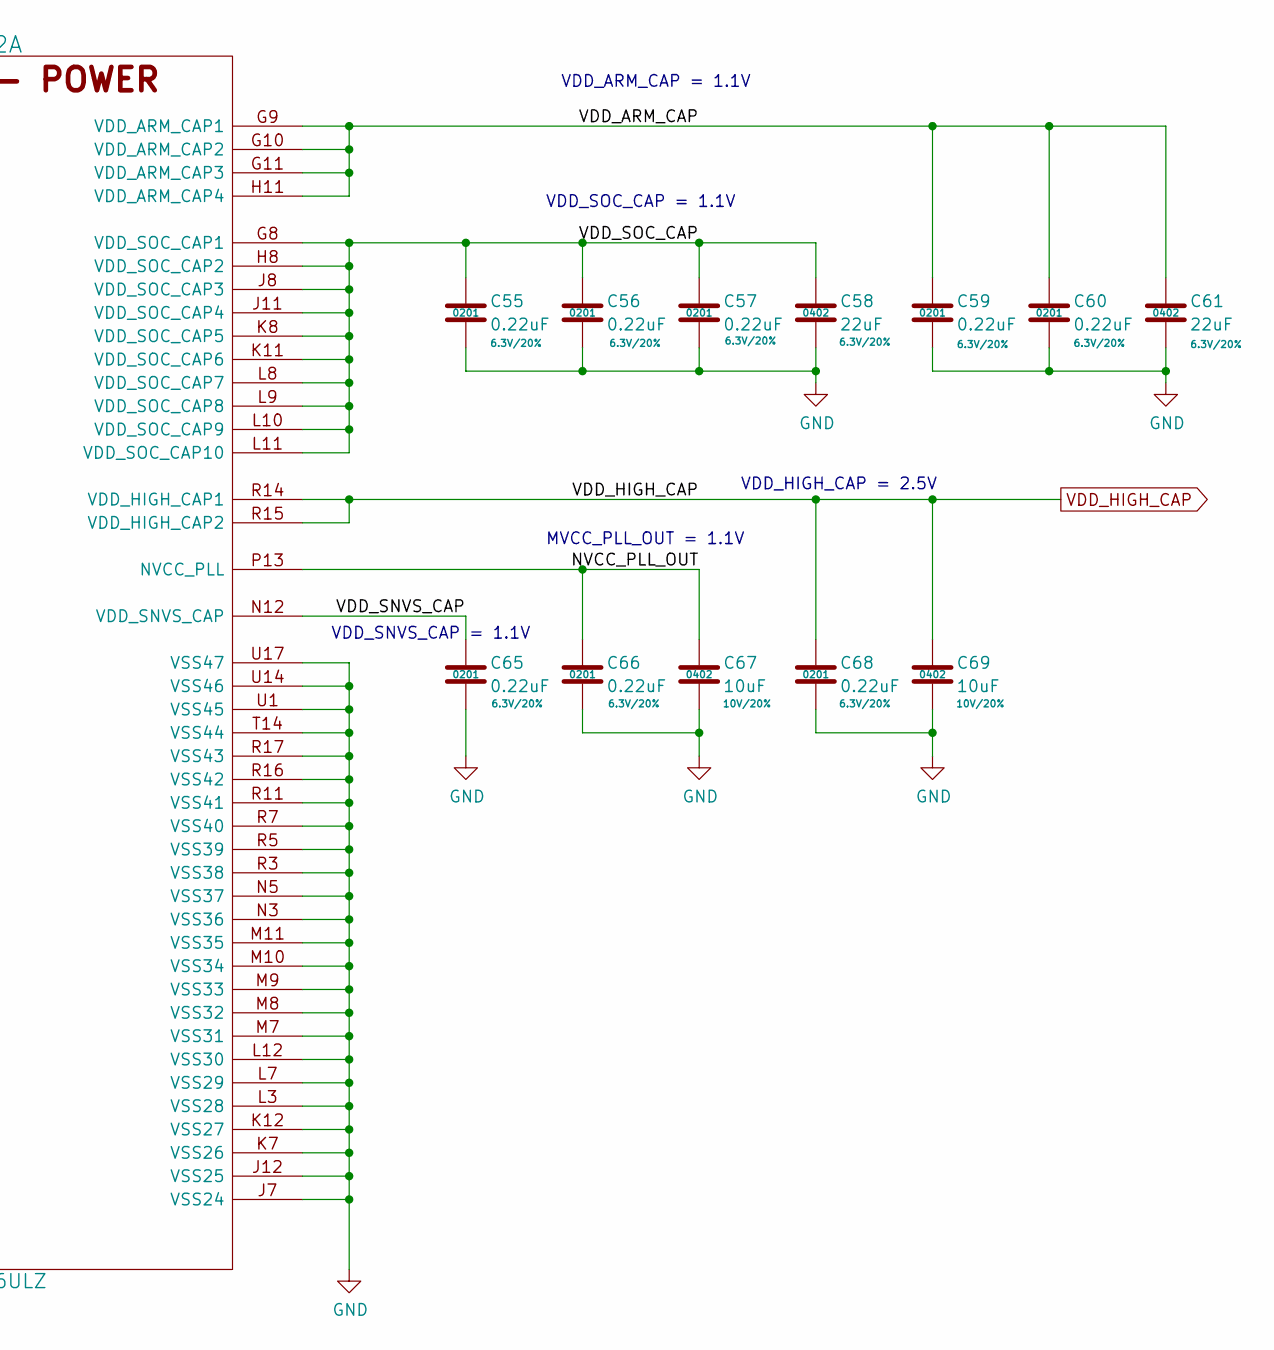
[picture p8: schematic power.sch, part in row 1, column 2]

Parts:
C51, C58, C61: 22uF; SM0402; Rating 6.3V/20%; Mfg PN CL05A226MQ5N6J8; Digi-Key_PN 1276-7090-1-ND
C52, C62: 4.7uF; SM0402; Rating 10V/20%; Mfg PN ZRB15XR61A475ME01D; Digi-Key_PN 490-10984-1-ND
C53, C54, C55, C56, C57, C59, C60, C63, C64, C65, C66, C68: 0.22uF; SM0201; Rating 6.3V/20%; Mfg PN GRM033R60J224ME15D; Digi-Key_PN 490-10407-1-ND
C67, C69: 10uF; SM0402; Rating 10V/20%; Mfg PN CL05A106MP8NUB8; Digi-Key_PN 1276-6830-1-ND
U2: i.MX6ULZ; SOT1534-2; Mfg PN MCIMX6Z0DVM09AB; Digi-Key_PN 568-14726-ND

Connections:
/Power/NVCC_PLL_OUT: C66.1, C67.1, U2.P13 (NVCC_PLL); also elsewhere on the board
/Power/VDD_ARM_CAP: C59.1, C60.1, C61.1, U2.G9 (VDD_ARM_CAP1), U2.G10 (VDD_ARM_CAP2), U2.G11 (VDD_ARM_CAP3), U2.H11 (VDD_ARM_CAP4); also elsewhere on the board
/Power/VDD_SNVS_CAP: C65.1, U2.N12 (VDD_SNVS_CAP); also elsewhere on the board
/Power/VDD_SOC_CAP: C55.1, C56.1, C57.1, C58.1, U2.G8 (VDD_SOC_CAP1), U2.H8 (VDD_SOC_CAP2), U2.J8 (VDD_SOC_CAP3), U2.J11 (VDD_SOC_CAP4), U2.K8 (VDD_SOC_CAP5), U2.K11 (VDD_SOC_CAP6), U2.L8 (VDD_SOC_CAP7), U2.L9 (VDD_SOC_CAP8), U2.L10 (VDD_SOC_CAP9), U2.L11 (VDD_SOC_CAP10); also elsewhere on the board
GND: C51.2, C52.2, C53.2, C54.2, C55.2, C56.2, C57.2, C58.2, C59.2, C60.2, C61.2, C62.2, C63.2, C64.2, C65.2, C66.2, C67.2, C68.2, C69.2, U2.A1 (VSS1), U2.A17 (VSS2), U2.C3 (VSS3), U2.C7 (VSS4), U2.C11 (VSS5), U2.C15 (VSS6), U2.E8 (VSS7), U2.E11 (VSS8), U2.F6 (VSS9), U2.F7 (VSS10), U2.F8 (VSS11), U2.F9 (VSS12), U2.F10 (VSS13), U2.F11 (VSS14), U2.F12 (VSS15), U2.G3 (VSS16), U2.G5 (VSS17), U2.G7 (VSS18), U2.G12 (VSS19), U2.G15 (VSS20), U2.H7 (VSS21), U2.H12 (VSS22), U2.J5 (VSS23), U2.J7 (VSS24), U2.J12 (VSS25), U2.K7 (VSS26), U2.K12 (VSS27), U2.L3 (VSS28), U2.L7 (VSS29), U2.L12 (VSS30), U2.M7 (VSS31), U2.M8 (VSS32), U2.M9 (VSS33), U2.M10 (VSS34), U2.M11 (VSS35), U2.M12 (NGND_KEL0), U2.N3 (VSS36), U2.N5 (VSS37), U2.R3 (VSS38), U2.R5 (VSS39), U2.R7 (VSS40), U2.R11 (VSS41), U2.R16 (VSS42), U2.R17 (VSS43), U2.T14 (VSS44), U2.U1 (VSS45), U2.U14 (VSS46), U2.U17 (VSS47); also elsewhere on the board
LDO2_3V3: C62.1, C63.1, C64.1, U2.N13 (VDD_HIGH_IN), U2.P12 (VDD_SNVS_IN); also elsewhere on the board
VDD_ARM_SOC_IN: C51.1, C52.1, C53.1, C54.1, U2.H9 (VDD_SOC_IN1), U2.H10 (VDD_SOC_IN2), U2.J9 (VDD_SOC_IN3), U2.J10 (VDD_SOC_IN4), U2.K9 (VDD_SOC_IN5), U2.K10 (VDD_SOC_IN6); also elsewhere on the board
VDD_HIGH_CAP: C68.1, C69.1, U2.R14 (VDD_HIGH_CAP1), U2.R15 (VDD_HIGH_CAP2); also elsewhere on the board

Notes on the sheet:
VDD_ARM_SOC_IN = 1.275V
VDD_ARM_CAP = 1.1V
VDD_SOC_CAP = 1.1V
VDD_HIGH_CAP = 2.5V
MVCC_PLL_OUT = 1.1V
VDD_SNVS_CAP = 1.1V

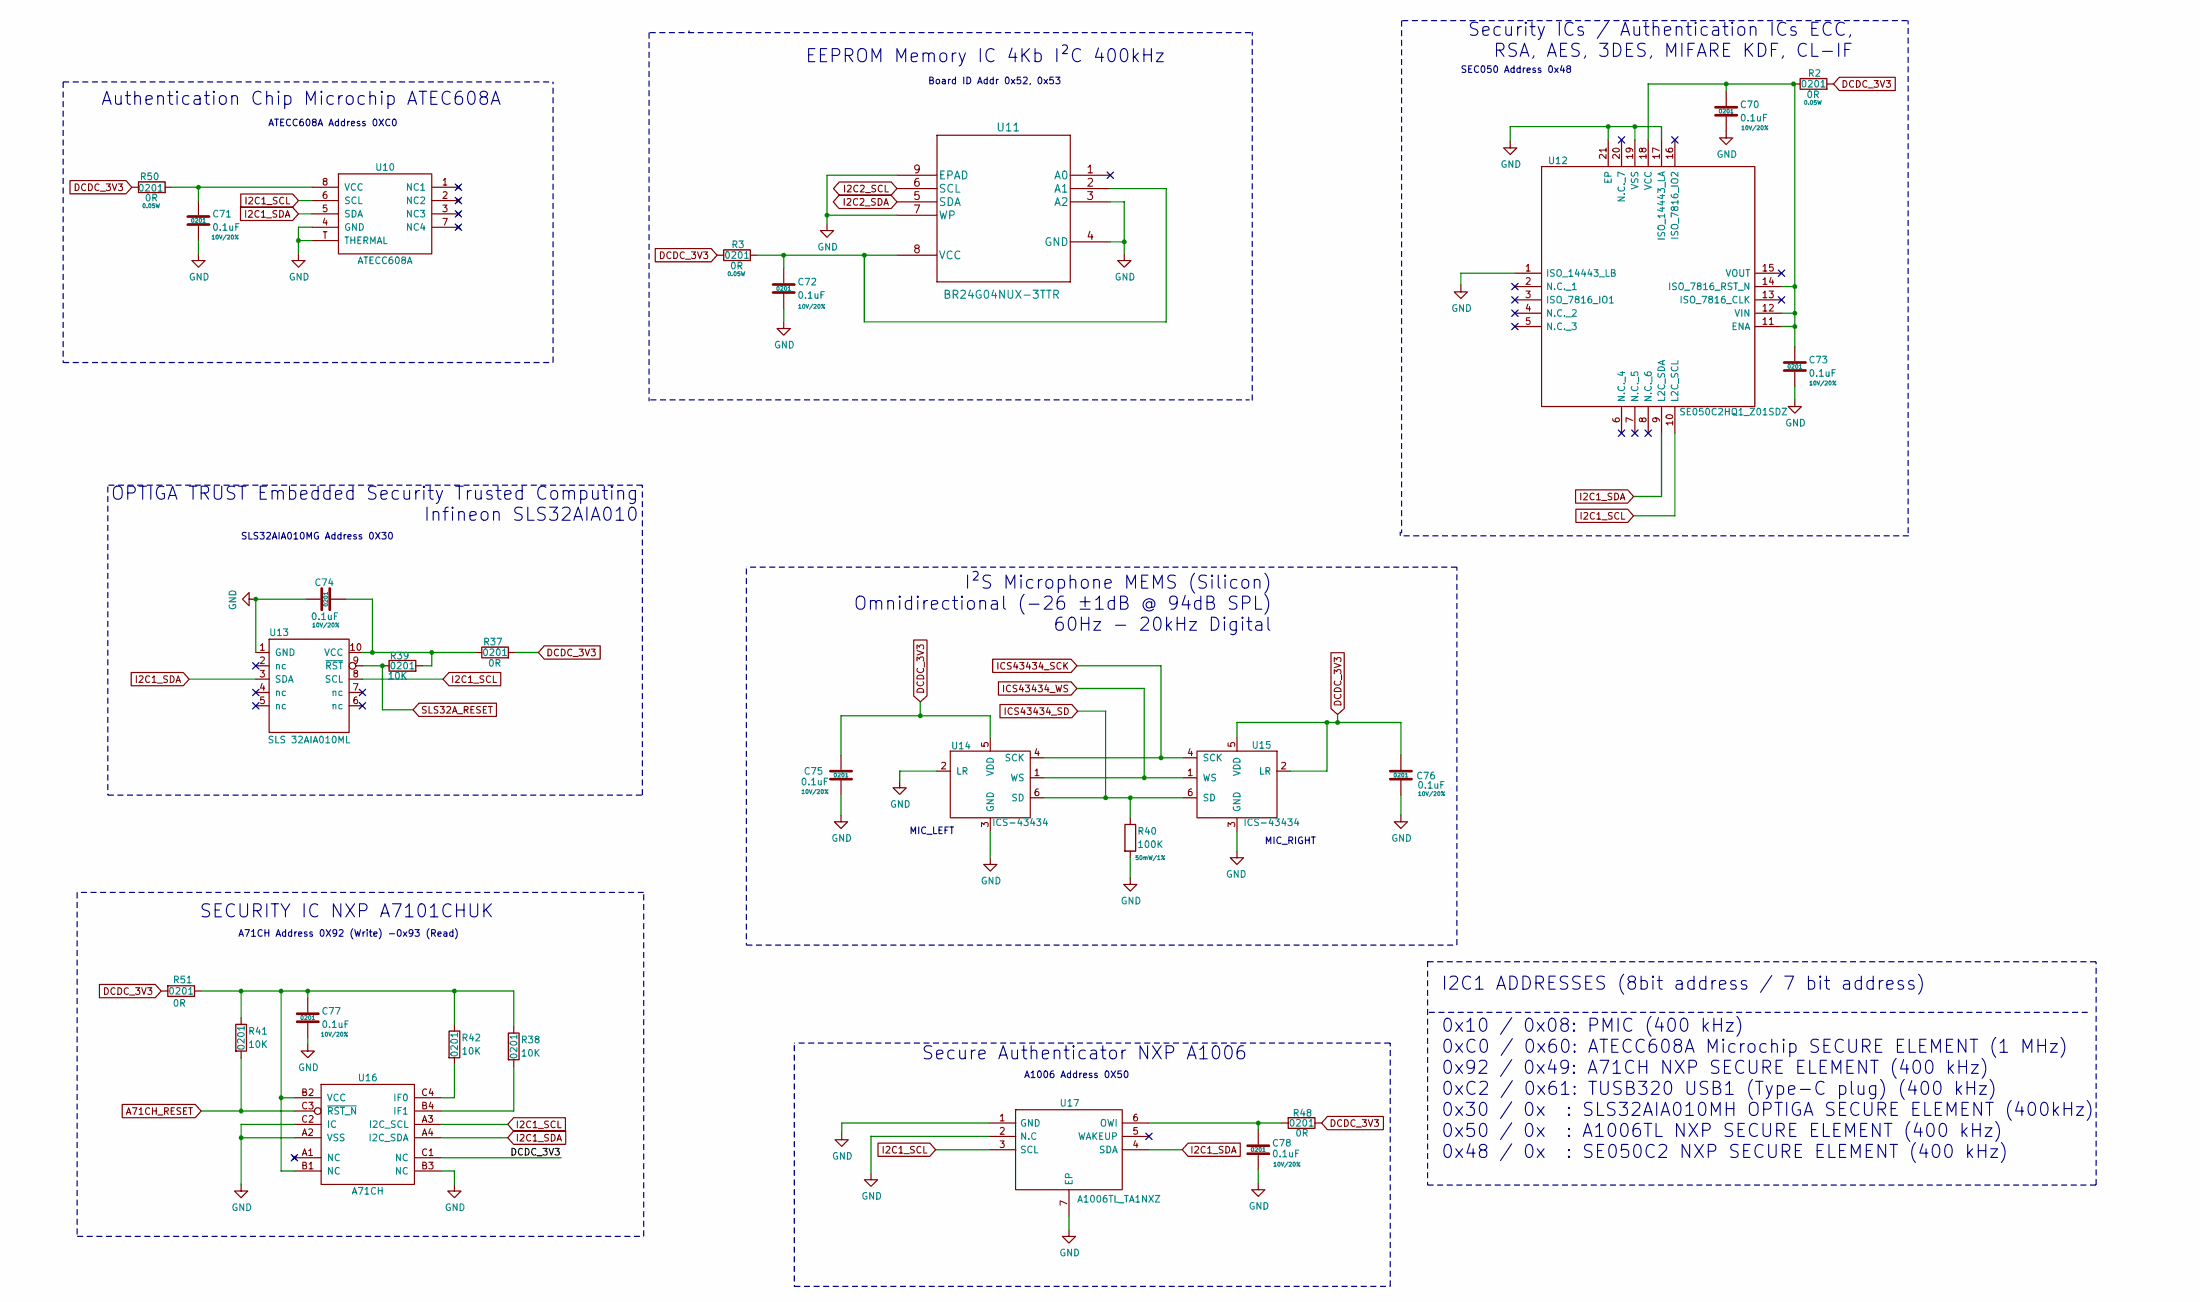
[picture p9: schematic secure-element.sch]

Parts:
C70, C71, C72, C73, C74, C75, C76, C77, C78: 0.1uF; SM0201; Rating 10V/20%; Mfg PN GRM033R61A104ME15D; Digi-Key_PN 490-5405-1-ND
R2, R3, R37, R50: 0R; R_0201_0603Metric; Rating 0.05W; Mfg PN CRCW02010000Z0ED; Digi-Key_PN 541-0.0AGCT-ND
R38, R39, R41, R42: 10K; R_0201_0603Metric; Rating 50mW/1%; Mfg PN CRCW020110K0JNED; Digi-Key_PN 541-10KAGCT-ND
R40: 100K; R_0201_0603Metric; Rating 50mW/1%; Mfg PN CRCW0201100KJNED; Digi-Key_PN 541-100KAGCT-ND
R48, R51: 0R; R_0201_0603Metric; Rating 50mW/1%; Mfg PN CRCW020110K0JNED; Digi-Key_PN 541-10KAGCT-ND
U10: ATECC608A; UDFN-8; Mfg PN ATECC608A-MAHDA; Digi-Key_PN ATECC608A-MAHDA-SCT-ND
U11: BR24G04NUX-3TTR; VSON008X2030_ROM; Mfg PN BR24G04NUX-3TTR; Digi-Key_PN BR24G04NUX-3TCT-ND
U12: SE050C2HQ1_Z01SDZ; QFN40P300X300X33-21N-D; Mfg PN SE050C2HQ1/Z01SDZ; Digi-Key_PN 568-15378-1-ND
U13: SLS 32AIA010ML; SLS; Mfg PN SLS32AIA010MH
U14, U15: ICS-43434; ICS43434; Mfg PN ICS-43434; Digi-Key_PN 1428-1066-1-ND
U16: A71CH; SOT1999-1; Mfg PN A7101CHUK/T0BC2HAZ; Digi-Key_PN 568-14698-1-ND
U17: A1006TL_TA1NXZ; SON65P200X200X50-7N; Mfg PN A1006TL/TA1NXZ; Digi-Key_PN 568-13635-1-ND

Connections:
A71CH_RESET: R41.2, U16.C3 (~RST_N); also elsewhere on the board
DCDC_3V3: C75.2, C76.2, R2.2, R3.1, R37.2, R48.1, R50.1, R51.2, U14.5 (VDD), U15.2 (LR), U15.5 (VDD), U16.C1 (NC); also elsewhere on the board
GND: C70.2, C71.2, C72.2, C73.2, C74.1, C75.1, C76.1, C77.2, C78.2, R40.2, U10.4 (GND), U10.T (THERMAL), U11.3 (A2), U11.4 (GND), U11.7 (WP), U11.9 (EPAD), U12.1 (ISO_14443_LB), U12.17 (ISO_14443_LA), U12.19 (VSS), U12.21 (EP), U13.1 (GND), U14.2 (LR), U14.3 (GND), U15.3 (GND), U16.A2 (VSS), U16.B3 (NC), U16.C2 (IC), U17.1 (GND), U17.2 (N.C), U17.7 (EP); also elsewhere on the board
I2C1_SCL: U10.6 (SCL), U12.10 (L2C_SCL), U13.8 (SCL), U16.A3 (I2C_SCL), U17.3 (SCL); also elsewhere on the board
I2C1_SDA: U10.5 (SDA), U12.9 (L2C_SDA), U13.3 (SDA), U16.A4 (I2C_SDA), U17.4 (SDA); also elsewhere on the board
I2C2_SCL: U11.6 (SCL); also elsewhere on the board
I2C2_SDA: U11.5 (SDA); also elsewhere on the board
ICS43434_SCK: U14.4 (SCK), U15.4 (SCK); also elsewhere on the board
ICS43434_SD: R40.1, U14.6 (SD), U15.6 (SD); also elsewhere on the board
ICS43434_WS: U14.1 (WS), U15.1 (WS); also elsewhere on the board
unnamed: C70.1, C73.1, R2.1, U12.11 (ENA), U12.12 (VIN), U12.14 (ISO_7816_RST_N), U12.18 (VCC)
unnamed: C71.1, R50.2, U10.8 (VCC)
unnamed: C72.1, R3.2, U11.2 (A1), U11.8 (VCC)
unnamed: C74.2, R37.1, R39.2, U13.10 (VCC)
unnamed: C77.1, R38.1, R41.1, R42.1, R51.1, U16.B1 (NC), U16.B2 (VCC)
unnamed: C78.1, R48.2, U17.6 (OWI)
unnamed: R38.2, U16.B4 (IF1)
unnamed: R42.2, U16.C4 (IF0)
SLS32A_RESET: R39.1, U13.9 (~RST); also elsewhere on the board

Notes on the sheet:
SLS32AIA010MG Address 0X30
A71CH Address 0X92 (Write) -0x93 (Read)
ATECC608A Address 0XC0
A1006 Address 0X50
SEC050 Address 0x48
Board ID Addr 0x52, 0x53
I2C1 ADDRESSES (8bit address / 7 bit address) 0x10 / 0x08: PMIC (400 kHz) 0xC0 / 0x60: ATECC608A Microchip SECURE ELEMENT (1 MHz) 0x92 / 0x49: A71CH NXP SECURE ELEMENT (400 kHz) 0xC2 / 0x61: TUSB320 USB1 (Type-C plug) (400 kHz) 0x30 / 0x : SLS32AIA010MH OPTIGA SECURE ELEMENT (400kHz) 0x50 / 0x : A1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
Secure Authenticator NXP A1006
I²S Microphone MEMS (Silicon) Omnidirectional (-26 ±1dB @ 94dB SPL) 60Hz - 20kHz Digital
Security ICs / Authentication ICs ECC, RSA, AES, 3DES, MIFARE KDF, CL-IF
EEPROM Memory IC 4Kb I²C 400kHz
OPTIGA TRUST Embedded Security Trusted Computing Infineon SLS32AIA010
SECURITY IC NXP A7101CHUK
Authentication Chip Microchip ATEC608A
MIC_RIGHT
MIC_LEFT
