FranciscoVentures/EN7745/Hardware/Curiosity.kicad_pcb

## KiCad design Hardware/Curiosity.kicad_pcb (continued)

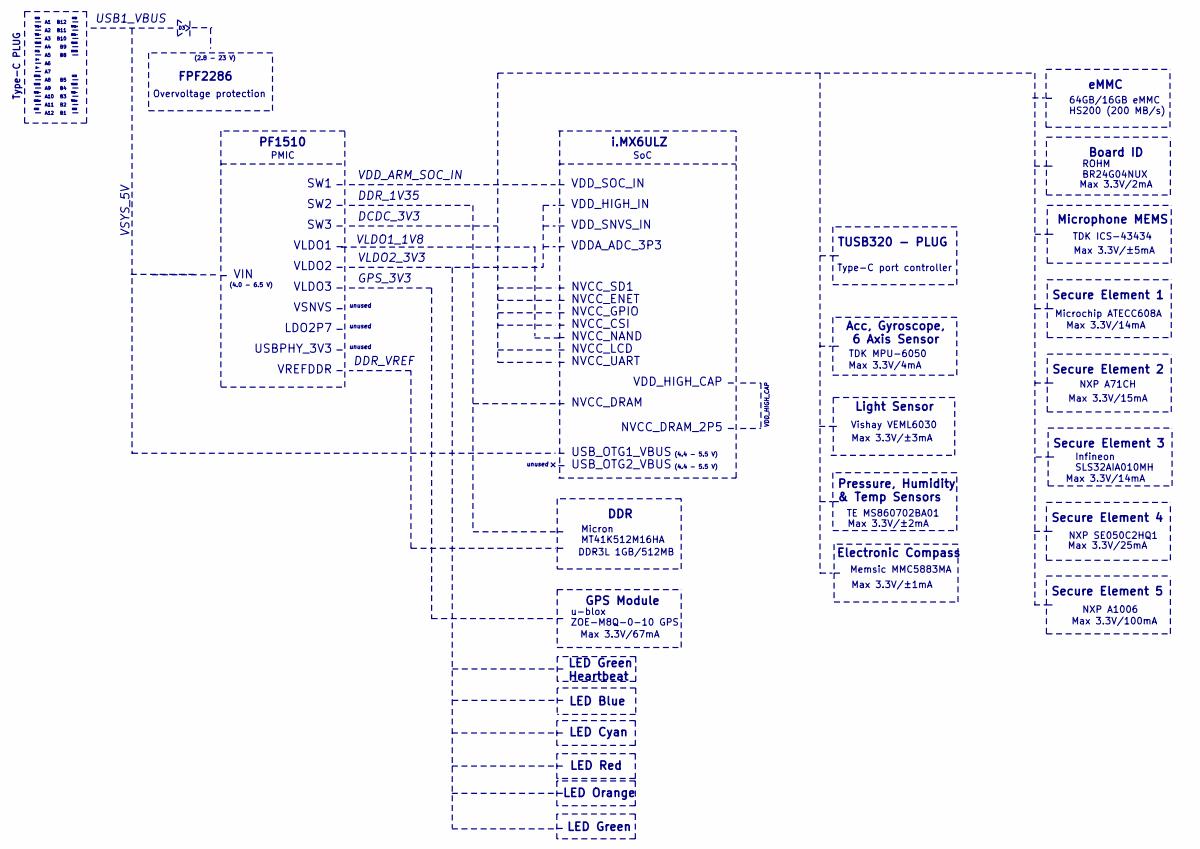
[picture p10: schematic power-tree.sch]

Notes on the sheet:
USB1_VBUS
i.MX6ULZ
NVCC_ENET
VDD_SOC_IN
VDD_HIGH_IN
VDD_SNVS_IN
USB_OTG1_VBUS
VDDA_ADC_3P3
NVCC_GPIO
NVCC_CSI
NVCC_NAND
NVCC_SD1
NVCC_LCD
NVCC_UART
USB_OTG2_VBUS
NVCC_DRAM
NVCC_DRAM_2P5
VIN
Type-C port controller
TUSB320 - PLUG
GPS Module
u-blox ZOE-M8Q-0-10 GPS
TDK ICS-43434
Microphone MEMS
DDR3L 1GB/512MB
DDR
Microchip ATECC608A
Secure Element 1
A10
A11
A12
B12
B11
B10
GND
TX1+
TX1-
VBUS
CC1
SBU1
RX2-
RX2+
RX1+
RX1-
SBU2
CC2
TX2-
TX2+
Type-C PLUG
Overvoltage protection
FPF2286
VSYS_5V
PMIC
PF1510
USBPHY_3V3
SW3
SW2
VLDO2
VLDO3
VSNVS
VLDO1
SW1
LDO2P7
VREFDDR
SoC
VDD_ARM_SOC_IN
DCDC_3V3
DDR_1V35
VLDO2_3V3
unused
NXP A71CH
Secure Element 2
VDD_HIGH_CAP
GPS_3V3
LED Green Heartbeat
LED Blue
(4.4 - 5.5 V)
DDR_VREF
(4.0 - 6.5 V)
(2.8 - 23 V)
Infineon SLS32AIA010MH
Secure Element 3
NXP SE050C2HQ1
Secure Element 4
NXP A1006
Secure Element 5
ROHM BR24G04NUX
Board ID
64GB/16GB eMMC HS200 (200 MB/s)
eMMC
TDK MPU-6050
Acc, Gyroscope, 6 Axis Sensor
Vishay VEML6030
Light Sensor
TE MS860702BA01
Pressure, Humidity & Temp Sensors
Memsic MMC5883MA
Electronic Compass
Max 3.3V/100mA
Max 3.3V/25mA
Max 3.3V/14mA
Max 3.3V/15mA
Max 3.3V/±5mA
Max 3.3V/2mA
Max 3.3V/4mA
Max 3.3V/±3mA
Max 3.3V/±2mA
Max 3.3V/±1mA
Max 3.3V/67mA
Micron MT41K512M16HA
VLDO1_1V8
LED Cyan
LED Red
LED Orange
LED Green

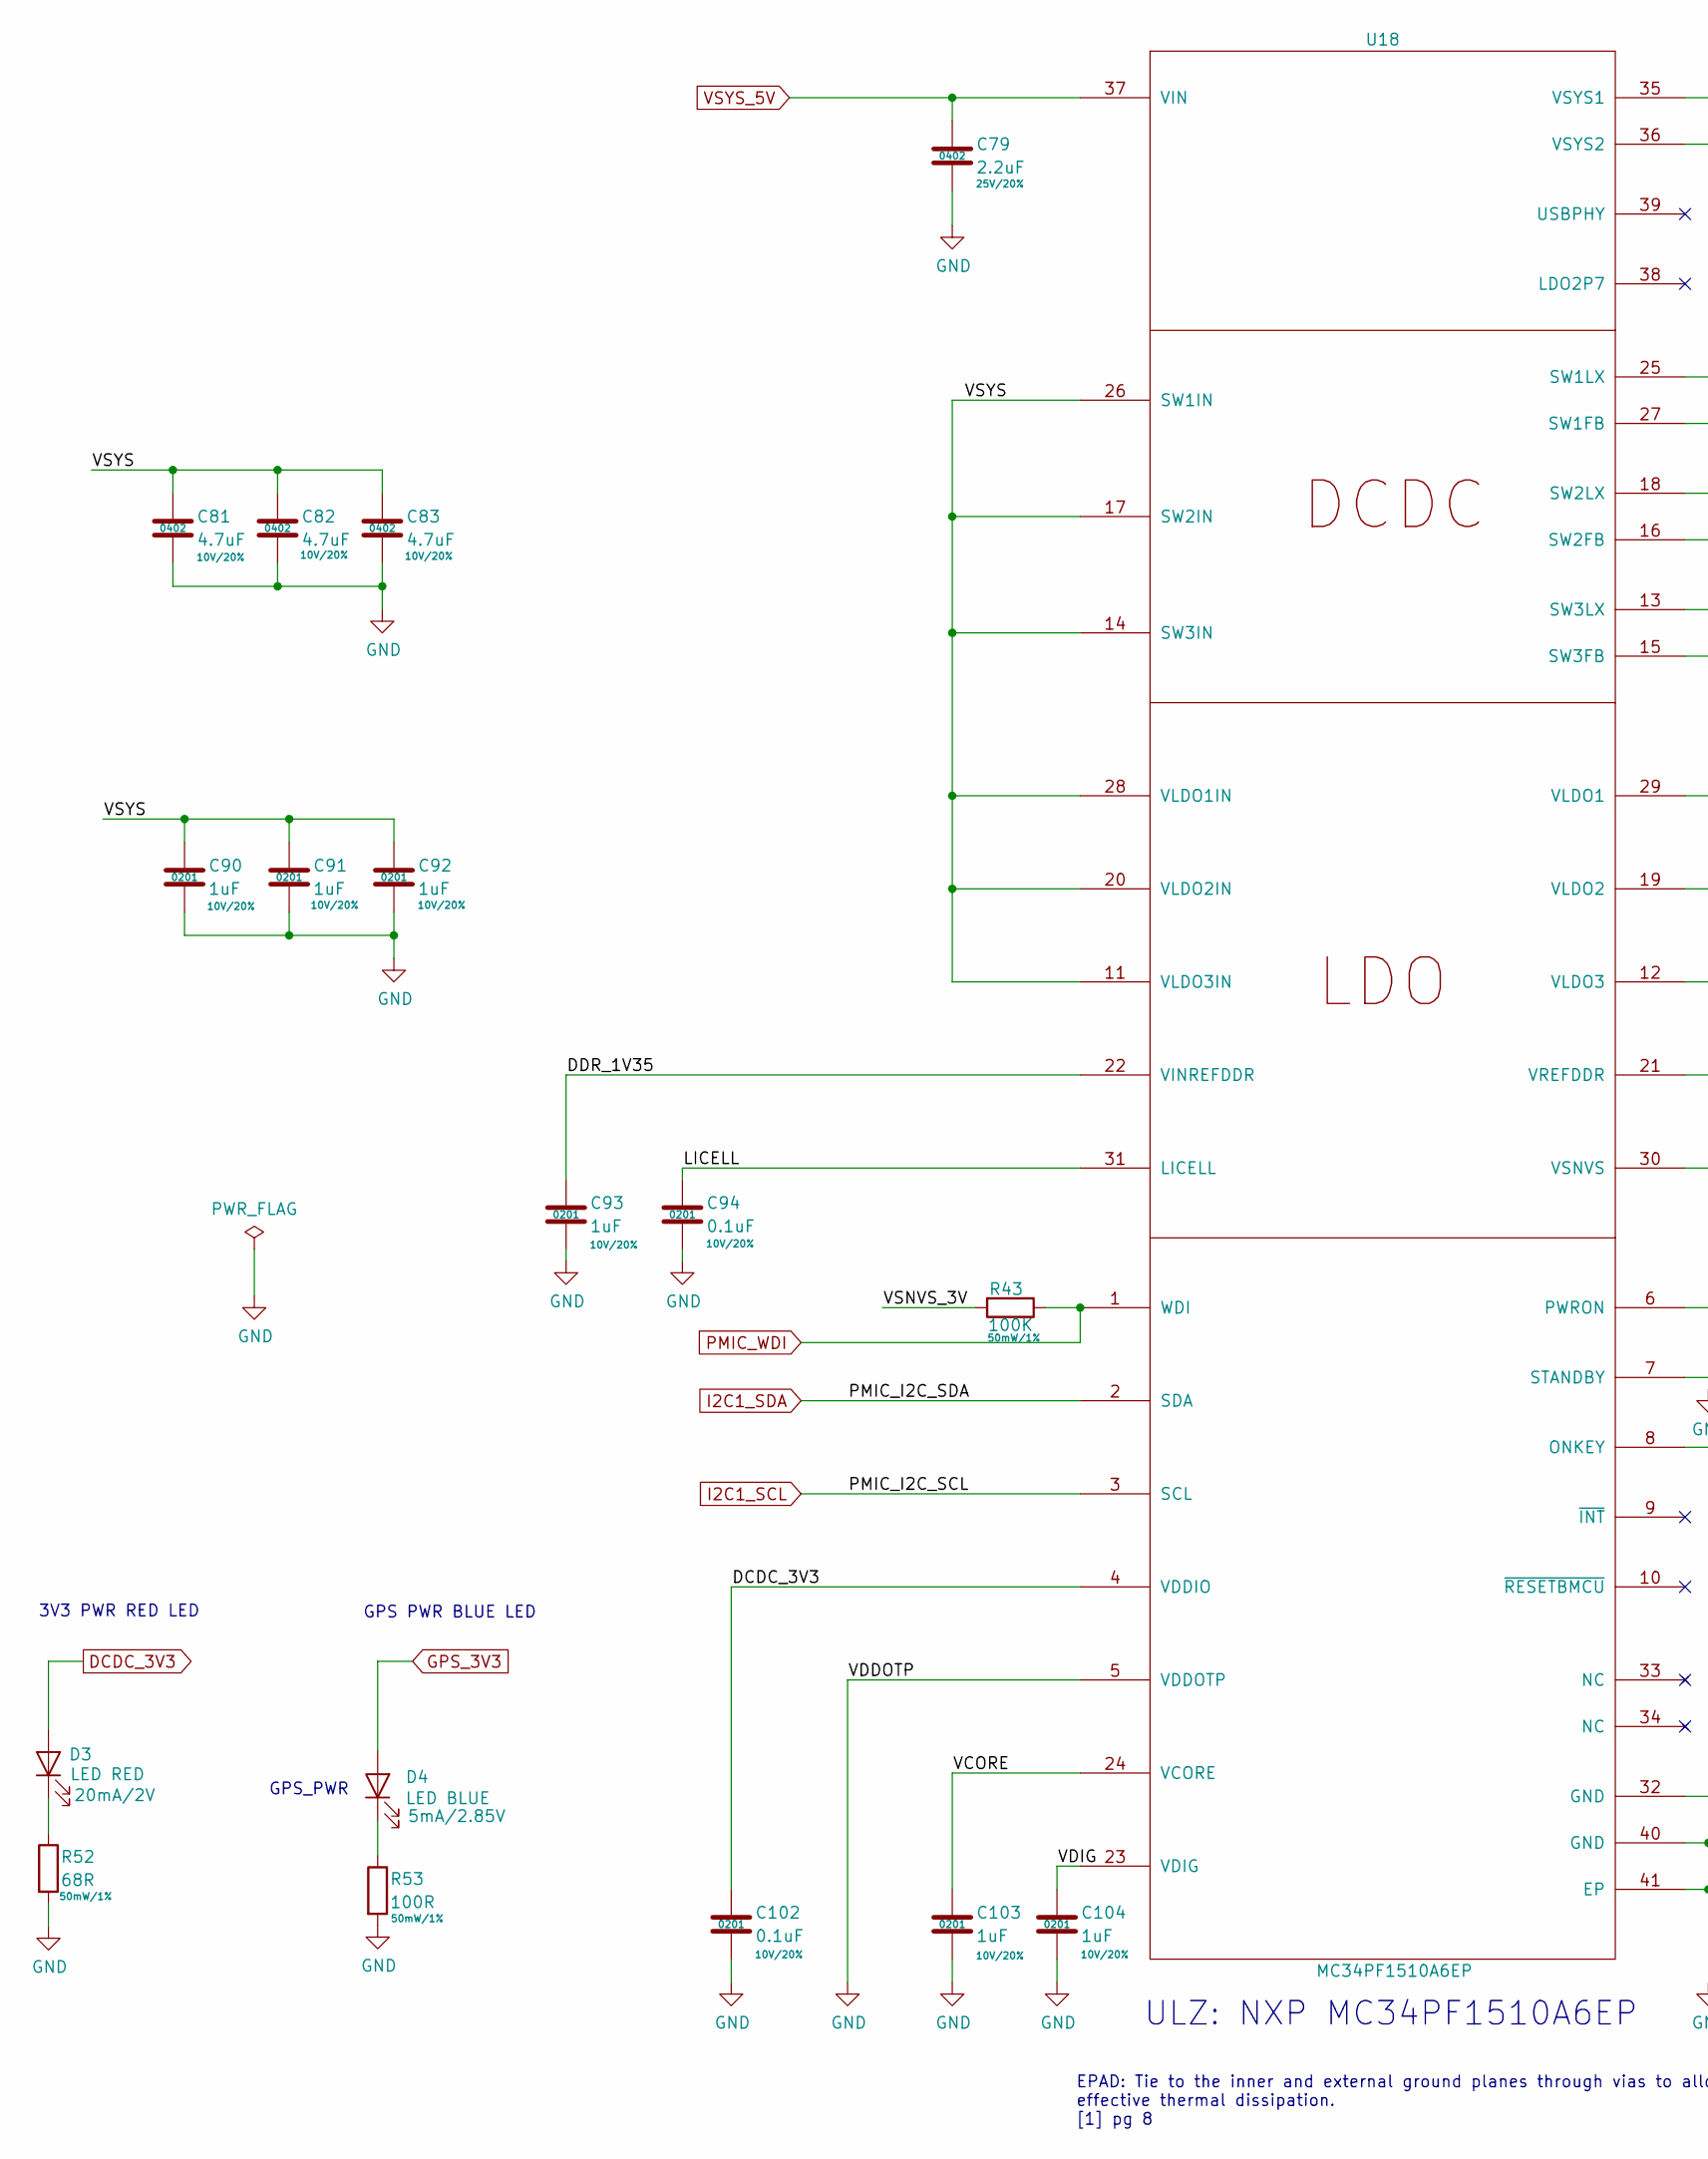
[picture p11: schematic pmic.sch, part in row 1, column 1]

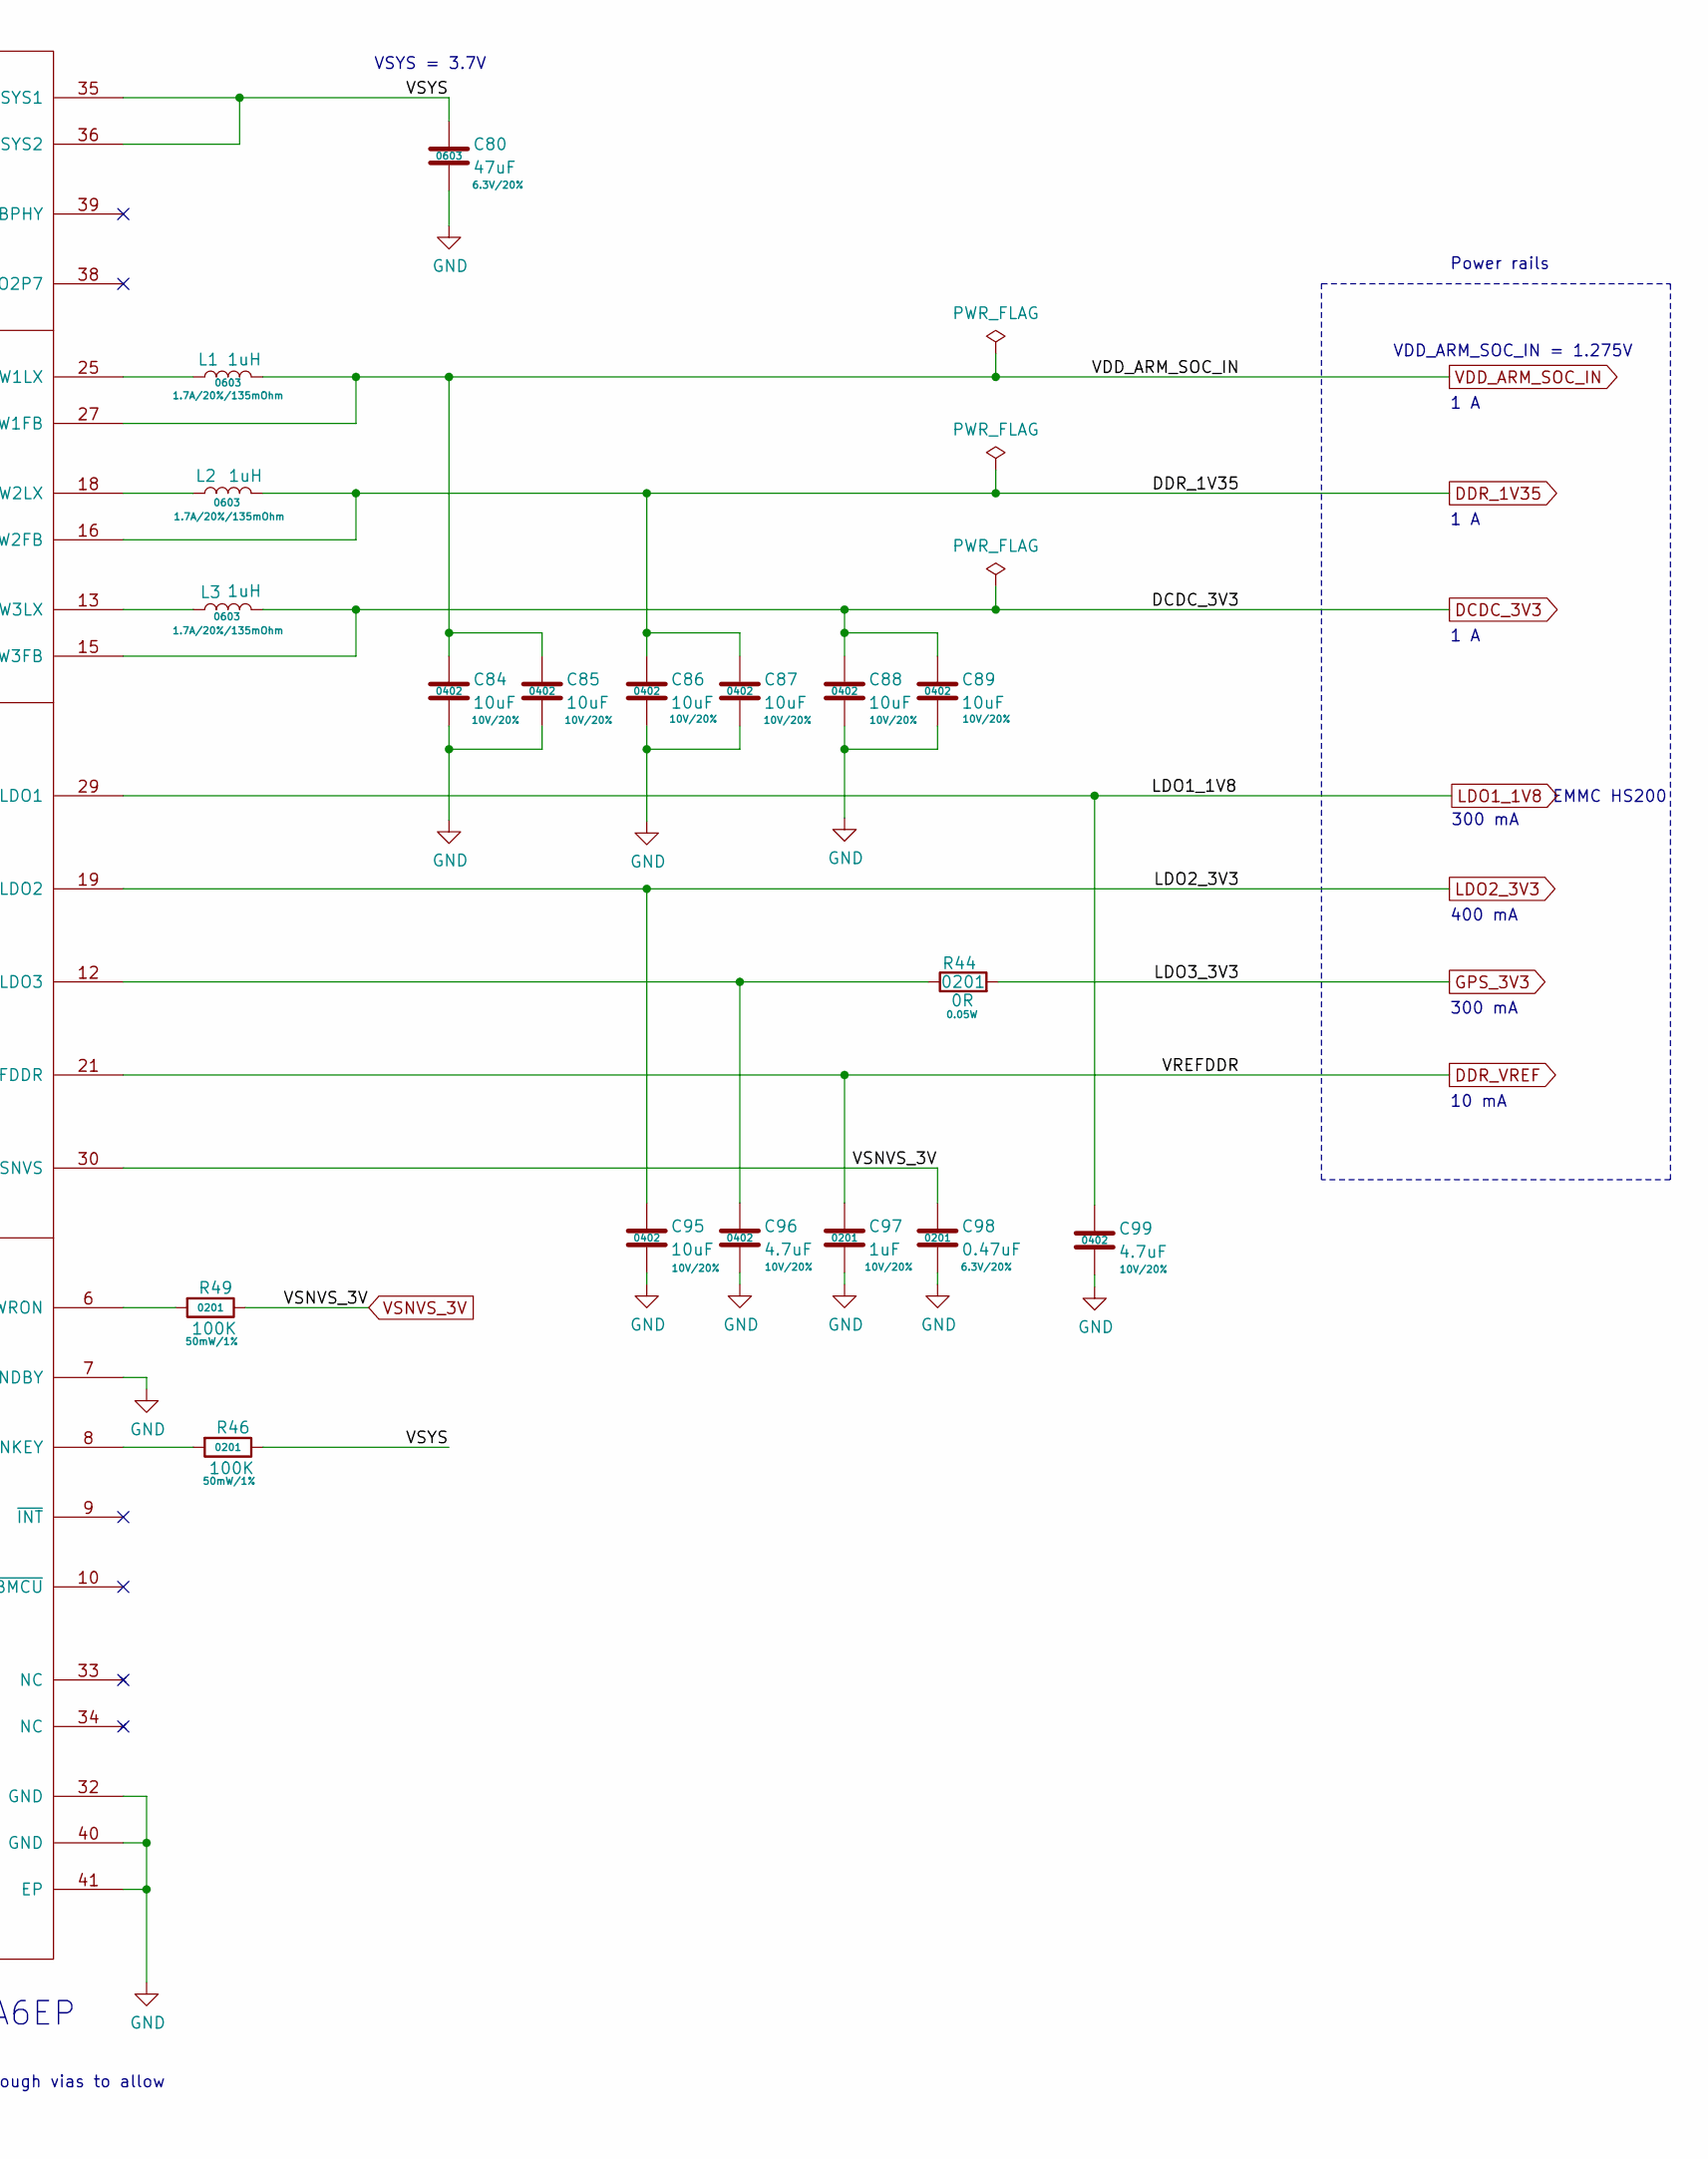
[picture p12: schematic pmic.sch, part in row 1, column 2]

Parts:
C79: 2.2uF; SM0402; Rating 25V/20%; Mfg PN GRM155R61E225ME15D; Digi-Key_PN 490-10457-1-ND
C80: 47uF; SM0603; Rating 6.3V/20%; Mfg PN GRM188R60J476ME15D; Digi-Key_PN 490-13247-1-ND
C81, C82, C83, C96, C99: 4.7uF; SM0402; Rating 10V/20%; Mfg PN ZRB15XR61A475ME01D; Digi-Key_PN 490-10984-1-ND
C84, C85, C86, C87, C88, C89, C95: 10uF; SM0402; Rating 10V/20%; Mfg PN CL05A106MP8NUB8; Digi-Key_PN 1276-6830-1-ND
C90, C91, C92, C93, C97, C103, C104: 1uF; SM0201; Rating 10V/20%; Mfg PN CL03A105MP3ZSNH; Digi-Key_PN 1276-6816-1-ND
C94, C102: 0.1uF; SM0201; Rating 10V/20%; Mfg PN GRM033R61A104ME15D; Digi-Key_PN 490-5405-1-ND
C98: 0.47uF; SM0201; Rating 6.3V/20%; Mfg PN GRM033R60J474ME90D; Digi-Key_PN 490-10410-1-ND
D3: LED RED; LED_0603; Rating 20mA/2V; Mfg PN LS Q976-NR-1; Digi-Key_PN 475-2512-1-ND
D4: LED BLUE; LED_0603; Rating 5mA/2.85V; Mfg PN LB Q39G-L2OO-35-1; Digi-Key_PN 475-2816-1-ND
L1, L2, L3: 1uH; SM0603; Rating 1.7A/20%/135mOhm; Mfg PN LPWI160808H1R0T; Digi-Key_PN F12082CT-ND
R43, R46, R49: 100K; R_0201_0603Metric; Rating 50mW/1%; Mfg PN CRCW0201100KJNED; Digi-Key_PN 541-100KAGCT-ND
R44: 0R; R_0201_0603Metric; Rating 0.05W; Mfg PN CRCW02010000Z0ED; Digi-Key_PN 541-0.0AGCT-ND
R52: 68R; R_0201_0603Metric; Rating 50mW/1%; Mfg PN CRCW020168R0FNED; Digi-Key_PN 541-CRCW020168R0FNEDCT-ND
R53: 100R; R_0201_0603Metric; Rating 50mW/1%; Mfg PN CRCW0201100RFNED; Digi-Key_PN 541-100ABCT-ND
U18: MC34PF1510A6EP; SOT1369-4; Mfg PN MC34PF1510A6EP; Digi-Key_PN 568-14653-1-ND

Connections:
/PMIC/LICELL: C94.1, U18.31 (LICELL)
/PMIC/VCORE: C103.1, U18.24 (VCORE)
/PMIC/VDIG: C104.1, U18.23 (VDIG)
/PMIC/VSYS: C80.1, C81.1, C82.1, C83.1, C90.1, C91.1, C92.1, R46.1, U18.11 (VLDO3IN), U18.14 (SW3IN), U18.17 (SW2IN), U18.20 (VLDO2IN), U18.26 (SW1IN), U18.28 (VLDO1IN), U18.35 (VSYS1), U18.36 (VSYS2)
DCDC_3V3: C88.1, C89.1, C102.1, D3.2 (A), L3.2, U18.4 (VDDIO), U18.15 (SW3FB); also elsewhere on the board
DDR_1V35: C86.1, C87.1, C93.1, L2.2, U18.16 (SW2FB), U18.22 (VINREFDDR); also elsewhere on the board
DDR_VREF: C97.1, U18.21 (VREFDDR); also elsewhere on the board
GND: C79.2, C80.2, C81.2, C82.2, C83.2, C84.2, C85.2, C86.2, C87.2, C88.2, C89.2, C90.2, C91.2, C92.2, C93.2, C94.2, C95.2, C96.2, C97.2, C98.2, C99.2, C102.2, C103.2, C104.2, R52.2, R53.2, U18.5 (VDDOTP), U18.7 (STANDBY), U18.32 (GND), U18.40 (GND), U18.41 (EP); also elsewhere on the board
GPS_3V3: D4.2 (A), R44.2
I2C1_SCL: U18.3 (SCL); also elsewhere on the board
I2C1_SDA: U18.2 (SDA); also elsewhere on the board
LDO1_1V8: C99.1, U18.29 (VLDO1); also elsewhere on the board
LDO2_3V3: C95.1, U18.19 (VLDO2); also elsewhere on the board
unnamed: C96.1, R44.1, U18.12 (VLDO3)
unnamed: D3.1 (K), R52.1
unnamed: D4.1 (K), R53.1
unnamed: L1.1, U18.25 (SW1LX)
unnamed: L2.1, U18.18 (SW2LX)
unnamed: L3.1, U18.13 (SW3LX)
unnamed: R46.2, U18.8 (ONKEY)
unnamed: R49.2, U18.6 (PWRON)
PMIC_WDI: R43.1, U18.1 (WDI); also elsewhere on the board
VDD_ARM_SOC_IN: C84.1, C85.1, L1.2, U18.27 (SW1FB); also elsewhere on the board
VSNVS_3V: C98.1, R43.2, R49.1, U18.30 (VSNVS); also elsewhere on the board
VSYS_5V: C79.1, U18.37 (VIN); also elsewhere on the board

Notes on the sheet:
EPAD: Tie to the inner and external ground planes through vias to allow effective thermal dissipation. [1] pg 8
400 mA
300 mA
1 A
10 mA
Power rails
ULZ: NXP MC34PF1510A6EP
3V3 PWR RED LED
GPS_PWR
GPS PWR BLUE LED
EMMC HS200
VSYS = 3.7V
VDD_ARM_SOC_IN = 1.275V

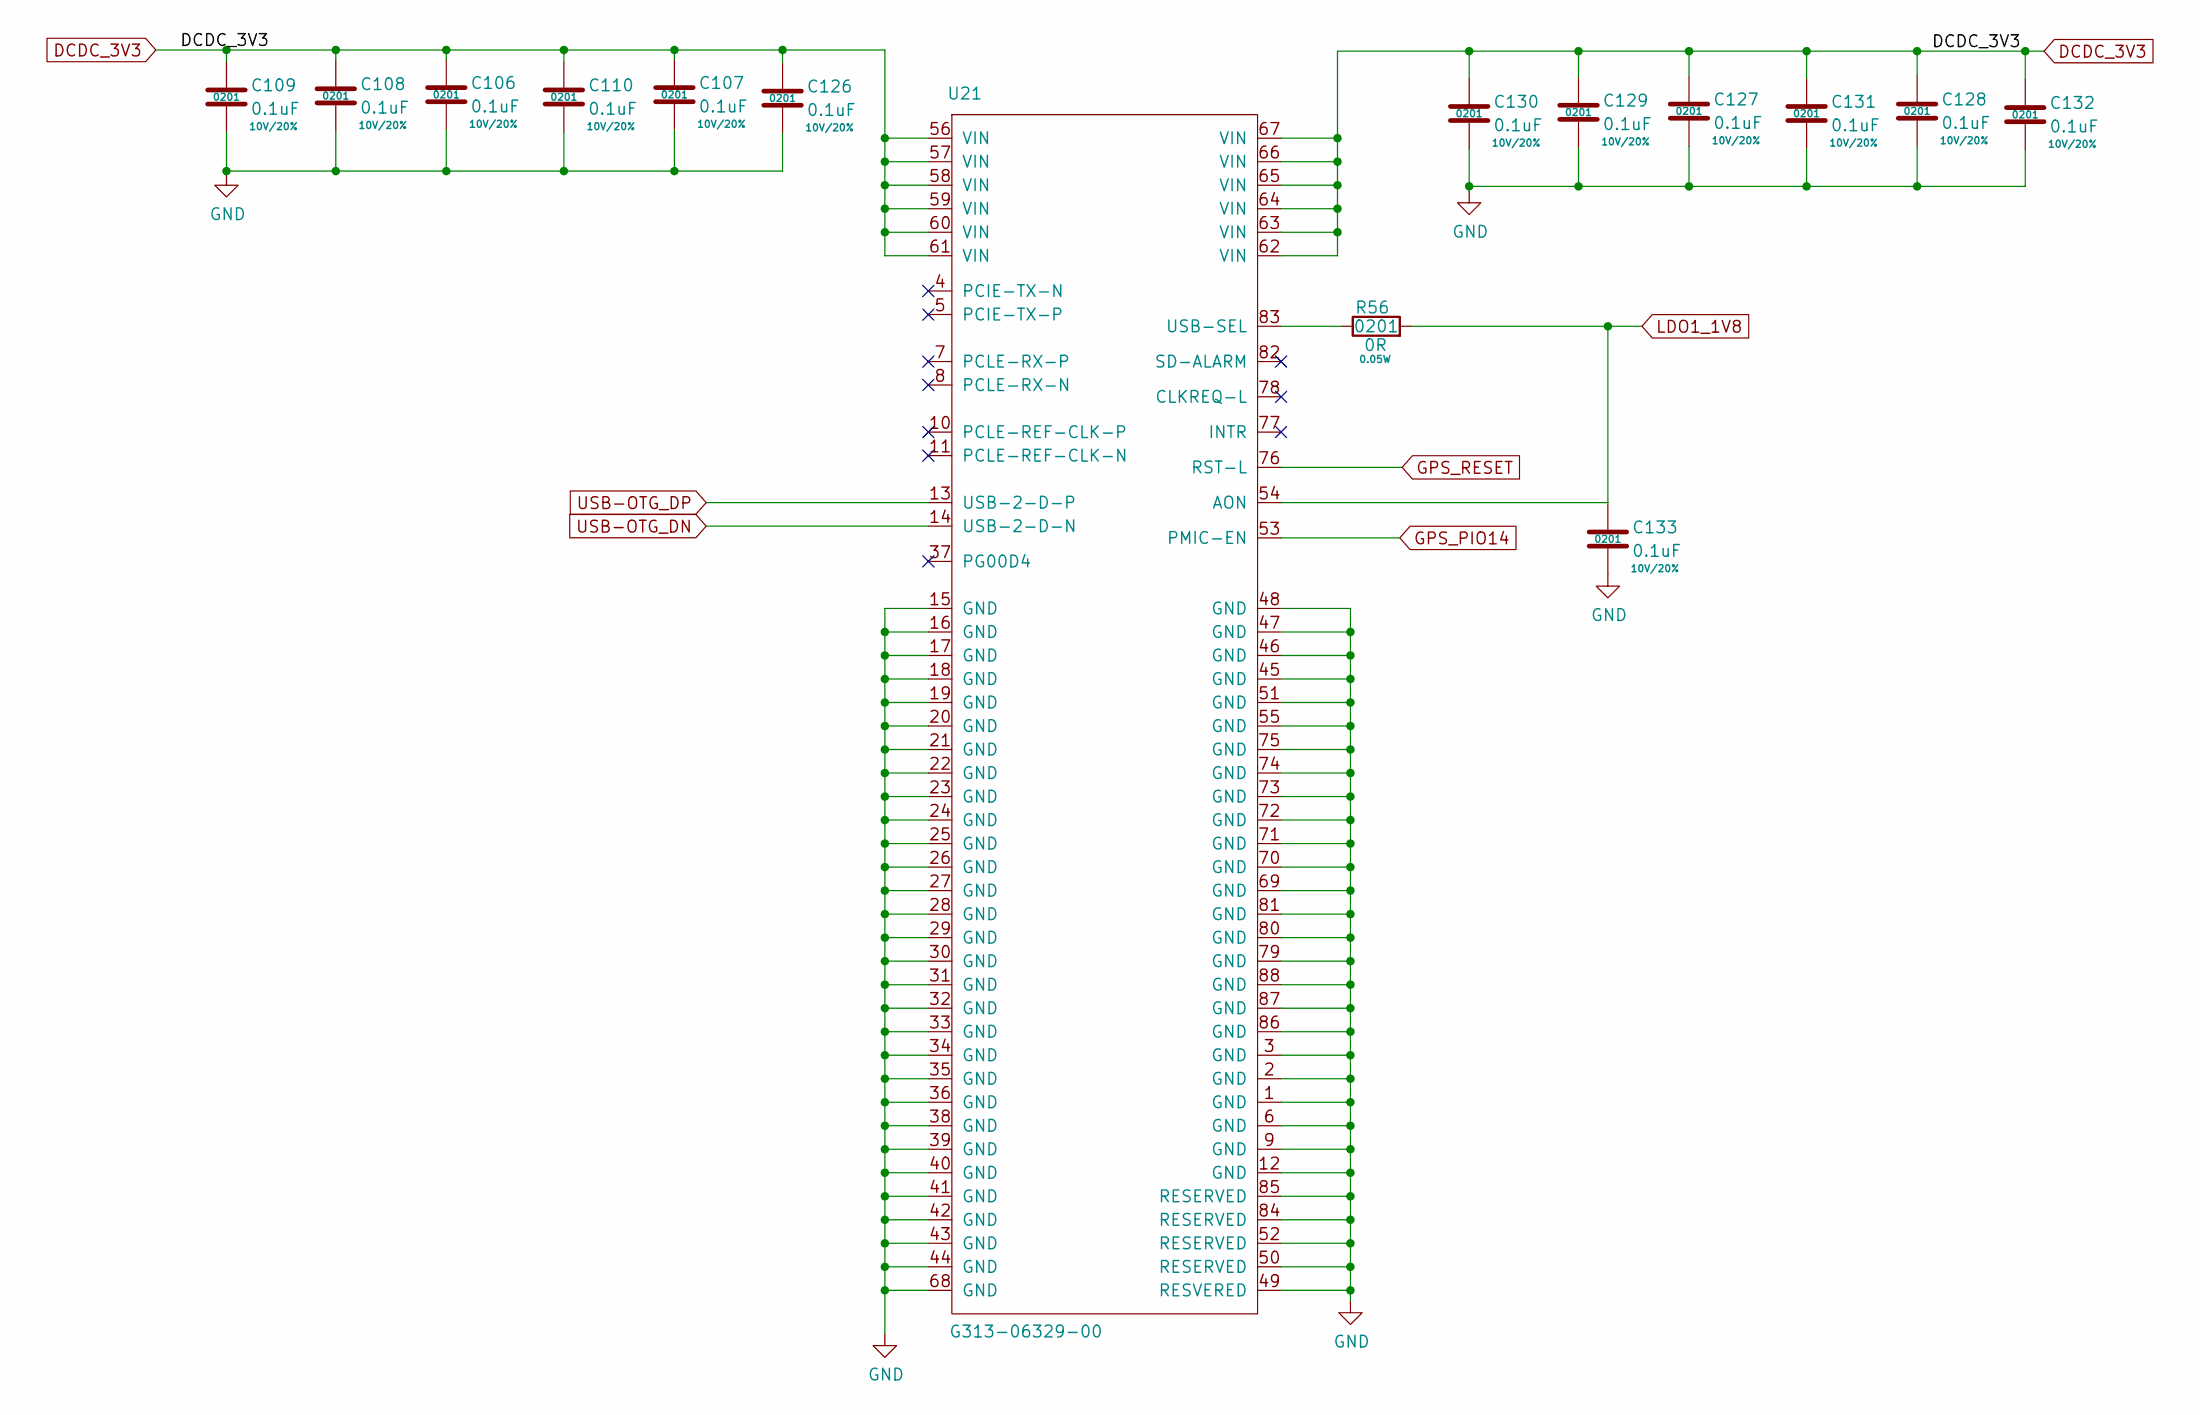
[picture p13: schematic GPS.sch]

Parts:
C106, C107, C108, C109, C110, C126, C127, C128, C129, C130, C131, C132, C133: 0.1uF; SM0201; Rating 10V/20%; Mfg PN GRM033R61A104ME15D; Digi-Key_PN 490-5405-1-ND
R56: 0R; R_0201_0603Metric; Rating 0.05W; Mfg PN CRCW02010000Z0ED; Digi-Key_PN 541-0.0AGCT-ND
U21: G313-06329-00; G3130632900

Connections:
DCDC_3V3: C106.1, C107.1, C108.1, C109.1, C110.1, C126.1, C127.1, C128.1, C129.1, C130.1, C131.1, C132.1, U21.56 (VIN), U21.57 (VIN), U21.58 (VIN), U21.59 (VIN), U21.60 (VIN), U21.61 (VIN), U21.62 (VIN), U21.63 (VIN), U21.64 (VIN), U21.65 (VIN), U21.66 (VIN), U21.67 (VIN); also elsewhere on the board
GND: C106.2, C107.2, C108.2, C109.2, C110.2, C126.2, C127.2, C128.2, C129.2, C130.2, C131.2, C132.2, C133.2, U21.1 (GND), U21.2 (GND), U21.3 (GND), U21.6 (GND), U21.9 (GND), U21.12 (GND), U21.15 (GND), U21.16 (GND), U21.17 (GND), U21.18 (GND), U21.19 (GND), U21.20 (GND), U21.21 (GND), U21.22 (GND), U21.23 (GND), U21.24 (GND), U21.25 (GND), U21.26 (GND), U21.27 (GND), U21.28 (GND), U21.29 (GND), U21.30 (GND), U21.31 (GND), U21.32 (GND), U21.33 (GND), U21.34 (GND), U21.35 (GND), U21.36 (GND), U21.38 (GND), U21.39 (GND), U21.40 (GND), U21.41 (GND), U21.42 (GND), U21.43 (GND), U21.44 (GND), U21.45 (GND), U21.46 (GND), U21.47 (GND), U21.48 (GND), U21.49 (RESVERED), U21.50 (RESERVED), U21.51 (GND), U21.52 (RESERVED), U21.55 (GND), U21.68 (GND), U21.69 (GND), U21.70 (GND), U21.71 (GND), U21.72 (GND), U21.73 (GND), U21.74 (GND), U21.75 (GND), U21.79 (GND), U21.80 (GND), U21.81 (GND), U21.84 (RESERVED), U21.85 (RESERVED), U21.86 (GND), U21.87 (GND), U21.88 (GND); also elsewhere on the board
GPS_PIO14: U21.53 (PMIC-EN); also elsewhere on the board
GPS_RESET: U21.76 (RST-L); also elsewhere on the board
LDO1_1V8: R56.2, U21.54 (AON); also elsewhere on the board
unnamed: R56.1, U21.83 (USB-SEL)

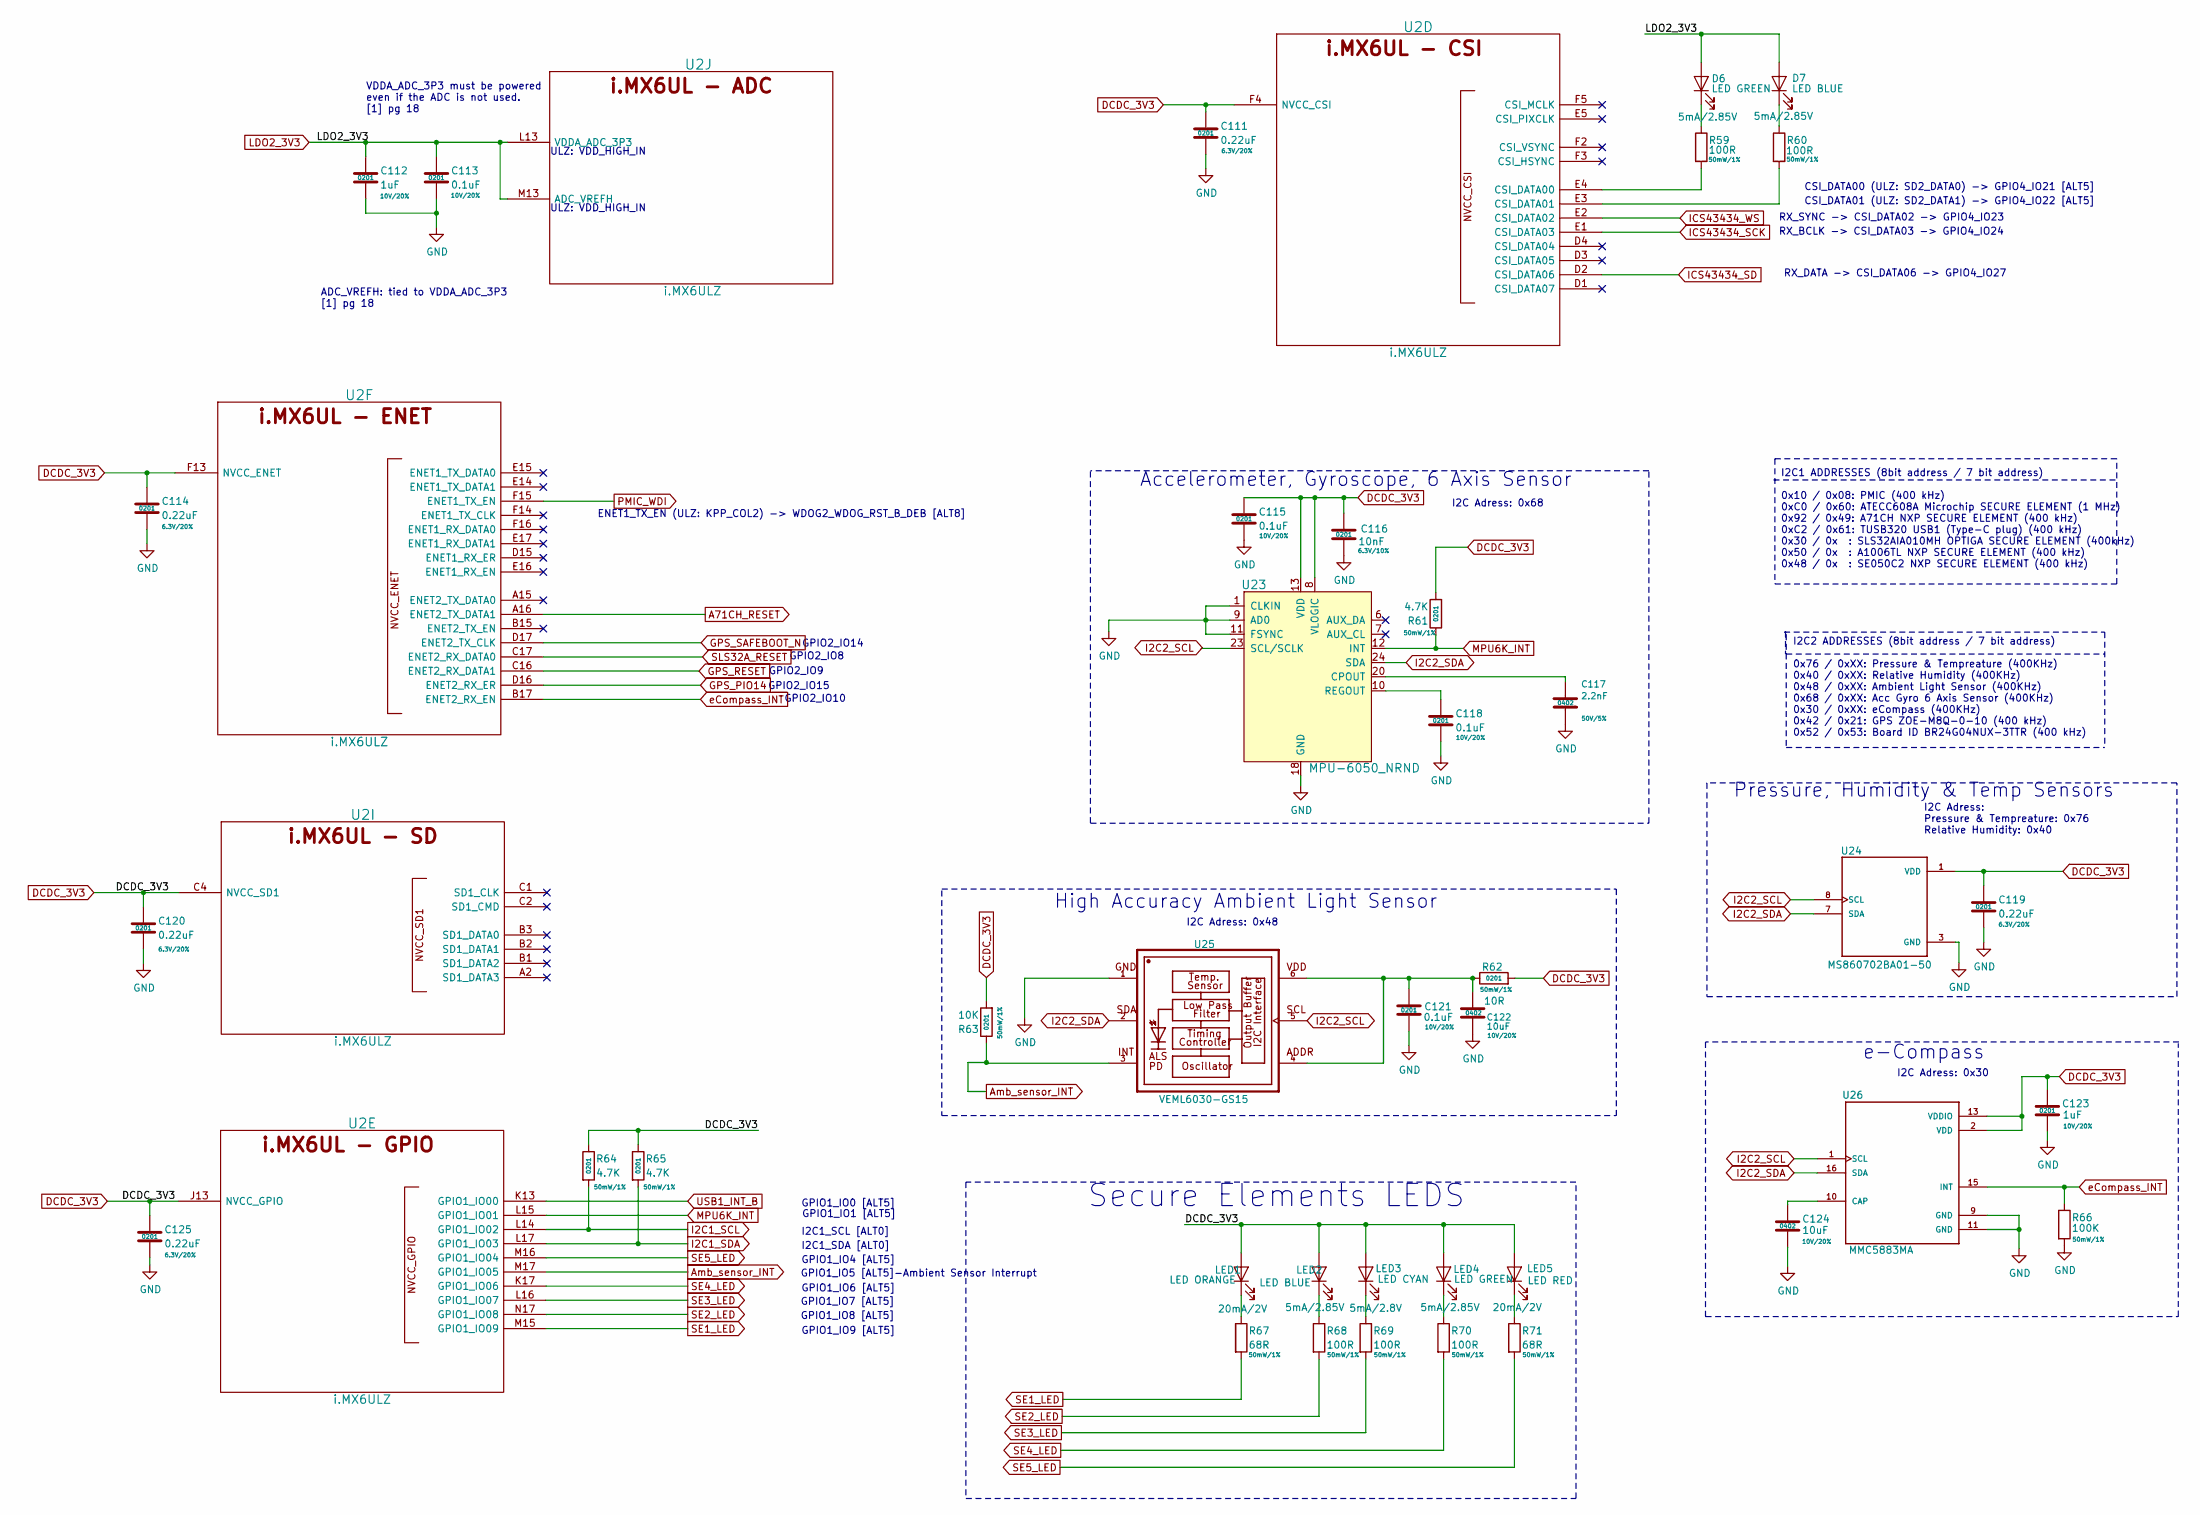
[picture p14: schematic misc.sch]

Parts:
C111, C114, C119, C120, C125: 0.22uF; SM0201; Rating 6.3V/20%; Mfg PN GRM033R60J224ME15D; Digi-Key_PN 490-10407-1-ND
C112, C123: 1uF; SM0201; Rating 10V/20%; Mfg PN CL03A105MP3ZSNH; Digi-Key_PN 1276-6816-1-ND
C113, C115, C118, C121: 0.1uF; SM0201; Rating 10V/20%; Mfg PN GRM033R61A104ME15D; Digi-Key_PN 490-5405-1-ND
C116: 10nF; SM0201; Rating 6.3V/10%; Mfg PN GRM033R70J103KA01D; Digi-Key_PN 490-1262-1-ND
C117: 2.2nF; C_0402_1005Metric; Rating 50V/5%; Mfg PN GRM155R71H222JA01J; Digi-Key_PN 490-6359-1-ND
C122: 10uF; C_0402_1005Metric; Rating 10V/20%; Mfg PN CL05A106MP8NUB8; Digi-Key_PN 1276-6830-1-ND
C124: 10uF; SM0402; Rating 10V/20%; Mfg PN CL05A106MP8NUB8; Digi-Key_PN 1276-6830-1-ND
D6: LED GREEN; LED_0603; Rating 5mA/2.85V; Mfg PN LT Q39G-Q1OO-25-1; Digi-Key_PN 475-3442-1-ND
D7: LED BLUE; SM0603_LED; Rating 5mA/2.85V; Mfg PN LB Q39G-L2OO-35-1; Digi-Key_PN 475-2816-1-ND
LED1: LED ORANGE; LED_0603; Rating 20mA/2V; Mfg PN LO Q976-PS-25-0-20-R18; Digi-Key_PN 475-2486-1-ND
LED2: LED BLUE; LED_0603; Rating 5mA/2.85V; Mfg PN LB Q39G-L2OO-35-1; Digi-Key_PN 475-2816-1-ND
LED3: LED CYAN; LED_0603; Rating 5mA/2.8V; Mfg PN APT1608VRCXF/A-5MAV; Digi-Key_PN 754-2180-1-ND
LED4: LED GREEN; LED_0603; Rating 5mA/2.85V; Mfg PN LT Q39G-Q1OO-25-1; Digi-Key_PN 475-3442-1-ND
LED5: LED RED; LED_0603; Rating 20mA/2V; Mfg PN LS Q976-NR-1; Digi-Key_PN 475-2512-1-ND
R59, R60, R68, R69, R70: 100R; R_0201_0603Metric; Rating 50mW/1%; Mfg PN CRCW0201100RFNED; Digi-Key_PN 541-100ABCT-ND
R61, R64, R65: 4.7K; R_0201_0603Metric; Rating 50mW/1%; Mfg PN CRCW02014K70JNED; Digi-Key_PN 541-4.7KAGCT-ND
R62: 10R; R_0201_0603Metric; Rating 50mW/1%; Mfg PN CRCW020110R0FNED; Digi-Key_PN 541-10.0ABCT-ND
R63: 10K; R_0201_0603Metric; Rating 50mW/1%; Mfg PN CRCW020110K0JNED; Digi-Key_PN 541-10KAGCT-ND
R66: 100K; R_0201_0603Metric; Rating 50mW/1%; Mfg PN CRCW0201100KJNED; Digi-Key_PN 541-100KAGCT-ND
R67, R71: 68R; R_0201_0603Metric; Rating 50mW/1%; Mfg PN CRCW020168R0FNED; Digi-Key_PN 541-CRCW020168R0FNEDCT-ND
U2: i.MX6ULZ; SOT1534-2; Mfg PN MCIMX6Z0DVM09AB; Digi-Key_PN 568-14726-ND
U23: MPU-6050_NRND; QFN-24-1EP_4x4mm; Mfg PN MPU-6050; Digi-Key_PN 1428-1007-1-ND
U24: MS860702BA01-50; TE_MS860702BA01-50; Mfg PN MS860702BA01-50; Digi-Key_PN 223-1701-1-ND
U25: VEML6030-GS15; VISHAY_VEML6030_2X2X0.87; Mfg PN VEML6030-GS15; Digi-Key_PN VEML6030-GS15CT-ND
U26: MMC5883MA; PQFN50P300X300X100-16N; Mfg PN MMC5883MA; Digi-Key_PN 1267-1072-1-ND

Connections:
A71CH_RESET: U2.A16 (ENET2_TX_DATA1); also elsewhere on the board
Amb_sensor_INT: R63.1, U2.M17 (GPIO1_IO05), U25.3; also elsewhere on the board
DCDC_3V3: C111.1, C114.1, C115.1, C116.1, C119.1, C120.1, C123.1, C125.1, LED1.2 (A), LED2.2 (A), LED3.2 (A), LED4.2 (A), LED5.2 (A), R61.2, R62.2, R63.2, R64.1, R65.1, U2.C4 (NVCC_SD1), U2.F4 (NVCC_CSI), U2.F13 (NVCC_ENET), U2.J13 (NVCC_GPIO), U23.8 (VLOGIC), U23.13 (VDD), U24.1 (VDD), U26.2 (VDD), U26.13 (VDDIO); also elsewhere on the board
GND: C111.2, C112.2, C113.2, C114.2, C115.2, C116.2, C117.2, C118.2, C119.2, C120.2, C121.2, C122.2, C123.2, C124.2, C125.2, R66.2, U23.1 (CLKIN), U23.9 (AD0), U23.11 (FSYNC), U23.18 (GND), U24.3 (GND), U25.1, U26.9 (GND), U26.11 (GND); also elsewhere on the board
GPS_PIO14: U2.D16 (ENET2_RX_ER); also elsewhere on the board
GPS_RESET: U2.C16 (ENET2_RX_DATA1); also elsewhere on the board
GPS_SAFEBOOT_N: U2.D17 (ENET2_TX_CLK); also elsewhere on the board
I2C1_SCL: R64.2, U2.L14 (GPIO1_IO02); also elsewhere on the board
I2C1_SDA: R65.2, U2.L17 (GPIO1_IO03); also elsewhere on the board
I2C2_SCL: U23.23 (SCL/SCLK), U24.8 (SCL), U25.5, U26.1 (SCL); also elsewhere on the board
I2C2_SDA: U23.24 (SDA), U24.7 (SDA), U25.2, U26.16 (SDA); also elsewhere on the board
ICS43434_SCK: U2.E1 (CSI_DATA03); also elsewhere on the board
ICS43434_SD: U2.D2 (CSI_DATA06); also elsewhere on the board
ICS43434_WS: U2.E2 (CSI_DATA02); also elsewhere on the board
LDO2_3V3: C112.1, C113.1, D6.2 (A), D7.2 (A), U2.L13 (VDDA_ADC_3P3), U2.M13 (ADC_VREFH); also elsewhere on the board
MPU6K_INT: R61.1, U2.L15 (GPIO1_IO01), U23.12 (INT); also elsewhere on the board
unnamed: C117.1, U23.20 (CPOUT)
unnamed: C118.1, U23.10 (REGOUT)
unnamed: C121.1, C122.1, R62.1, U25.4, U25.6
unnamed: C124.1, U26.10 (CAP)
unnamed: D6.1 (K), R59.1
unnamed: D7.1 (K), R60.1
unnamed: LED1.1 (K), R67.1
unnamed: LED2.1 (K), R68.1
unnamed: LED3.1 (K), R69.1
unnamed: LED4.1 (K), R70.1
unnamed: LED5.1 (K), R71.1
unnamed 172: R59.2, U2.E4 (CSI_DATA00); also elsewhere on the board
unnamed 173: R60.2, U2.E3 (CSI_DATA01); also elsewhere on the board
unnamed 174: U2.A2 (SD1_DATA3); also elsewhere on the board
unnamed 178: U2.A15 (ENET2_TX_DATA0); also elsewhere on the board
unnamed 179: U2.B1 (SD1_DATA2); also elsewhere on the board
unnamed 180: U2.B2 (SD1_DATA1); also elsewhere on the board
unnamed 181: U2.B3 (SD1_DATA0); also elsewhere on the board
unnamed 184: U2.B15 (ENET2_TX_EN); also elsewhere on the board
unnamed 185: U2.C1 (SD1_CLK); also elsewhere on the board
unnamed 186: U2.C2 (SD1_CMD); also elsewhere on the board
unnamed 189: U2.D1 (CSI_DATA07); also elsewhere on the board
unnamed 190: U2.D3 (CSI_DATA05); also elsewhere on the board
unnamed 191: U2.D4 (CSI_DATA04); also elsewhere on the board
unnamed 194: U2.D15 (ENET1_RX_ER); also elsewhere on the board
unnamed 195: U2.E5 (CSI_PIXCLK); also elsewhere on the board
unnamed 198: U2.E14 (ENET1_TX_DATA1); also elsewhere on the board
unnamed 199: U2.E15 (ENET1_TX_DATA0); also elsewhere on the board
unnamed 200: U2.E16 (ENET1_RX_EN); also elsewhere on the board
unnamed 201: U2.E17 (ENET1_RX_DATA1); also elsewhere on the board
unnamed 203: U2.F2 (CSI_VSYNC); also elsewhere on the board
unnamed 204: U2.F3 (CSI_HSYNC); also elsewhere on the board
unnamed 205: U2.F5 (CSI_MCLK); also elsewhere on the board
unnamed 206: U2.F14 (ENET1_TX_CLK); also elsewhere on the board
unnamed 207: U2.F16 (ENET1_RX_DATA0); also elsewhere on the board
PMIC_WDI: U2.F15 (ENET1_TX_EN); also elsewhere on the board
SE1_LED: R67.2, U2.M15 (GPIO1_IO09); also elsewhere on the board
SE2_LED: R68.2, U2.N17 (GPIO1_IO08); also elsewhere on the board
SE3_LED: R69.2, U2.L16 (GPIO1_IO07); also elsewhere on the board
SE4_LED: R70.2, U2.K17 (GPIO1_IO06); also elsewhere on the board
SE5_LED: R71.2, U2.M16 (GPIO1_IO04); also elsewhere on the board
SLS32A_RESET: U2.C17 (ENET2_RX_DATA0); also elsewhere on the board
USB1_INT_B: U2.K13 (GPIO1_IO00); also elsewhere on the board
eCompass_INT: R66.1, U2.B17 (ENET2_RX_EN), U26.15 (INT); also elsewhere on the board

Notes on the sheet:
ADC_VREFH: tied to VDDA_ADC_3P3 [1] pg 18
VDDA_ADC_3P3 must be powered even if the ADC is not used. [1] pg 18
I2C1_SCL [ALT0]
I2C1_SDA [ALT0]
GPIO1_IO9 [ALT5]
GPIO1_IO6 [ALT5]
GPIO1_IO4 [ALT5]
I2C1 ADDRESSES (8bit address / 7 bit address) 0x10 / 0x08: PMIC (400 kHz) 0xC0 / 0x60: ATECC608A Microchip SECURE ELEMENT (1 MHz) 0x92 / 0x49: A71CH NXP SECURE ELEMENT (400 kHz) 0xC2 / 0x61: TUSB320 USB1 (Type-C plug) (400 kHz) 0x30 / 0x : SLS32AIA010MH OPTIGA SECURE ELEMENT (400kHz) 0x50 / 0x : A1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
GPIO1_IO0 [ALT5]
ENET1_TX_EN (ULZ: KPP_COL2) -> WDOG2_WDOG_RST_B_DEB [ALT8]
CSI_DATA00 (ULZ: SD2_DATA0) -> GPIO4_IO21 [ALT5]
CSI_DATA01 (ULZ: SD2_DATA1) -> GPIO4_IO22 [ALT5]
ULZ: VDD_HIGH_IN
Secure Elements LEDS
Pressure, Humidity & Temp Sensors
I2C Adress: Pressure & Tempreature: 0x76 Relative Humidity: 0x40
High Accuracy Ambient Light Sensor
I2C Adress: 0x48
GPIO1_IO5 [ALT5]-Ambient Sensor Interrupt
GPIO1_IO7 [ALT5]
GPIO1_IO8 [ALT5]
I2C Adress: 0x68
GPIO1_IO1 [ALT5]
Accelerometer, Gyroscope, 6 Axis Sensor
RX_SYNC -> CSI_DATA02 -> GPIO4_IO23
RX_BCLK -> CSI_DATA03 -> GPIO4_IO24
RX_DATA -> CSI_DATA06 -> GPIO4_IO27
GPIO2_IO8
GPIO2_IO9
GPIO2_IO15
e-Compass
I2C Adress: 0x30
GPIO2_IO14
I2C2 ADDRESSES (8bit address / 7 bit address) 0x76 / 0xXX: Pressure & Tempreature (400KHz) 0x40 / 0xXX: Relative Humidity (400KHz) 0x48 / 0xXX: Ambient Light Sensor (400KHz) 0x68 / 0xXX: Acc Gyro 6 Axis Sensor (400KHz) 0x30 / 0xXX: eCompass (400KHz) 0x42 / 0x21: GPS ZOE-M8Q-0-10 (400 kHz) 0x52 / 0x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
GPIO2_IO10
