FranciscoVentures/EN7745/Hardware/Curiosity.kicad_pcb

## KiCad design Hardware/Curiosity.kicad_pcb (continued)

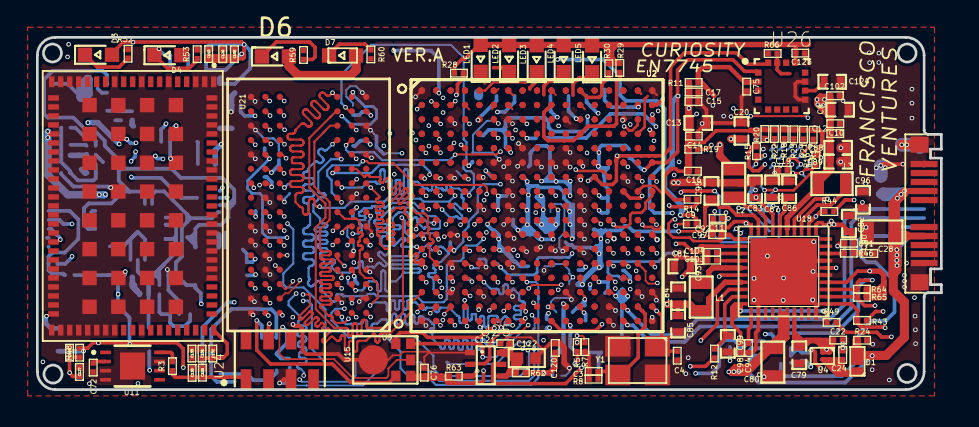
[picture p15: board Curiosity.kicad_pcb from above]

Board: 8 copper layers, 50.2 x 19.6 mm, 234 parts (0 on the bottom side), 247 nets.

Other parts of the board:
U2#2: i.MX6ULZ; SOT1534-2

Their connections:
/Boot/BT_CFG1[0]: U2#2.B9; also elsewhere on the board
/Boot/BT_CFG1[1]: U2#2.A9; also elsewhere on the board
/Boot/BT_CFG1[2]: U2#2.E10; also elsewhere on the board
/Boot/BT_CFG1[3]: U2#2.D10; also elsewhere on the board
/Boot/BT_CFG1[4]: U2#2.C10; also elsewhere on the board
/Boot/BT_CFG1[5]: U2#2.B10, U2#2.D12; also elsewhere on the board
/Boot/BT_CFG1[6]: U2#2.A10; also elsewhere on the board
/Boot/BT_CFG1[7]: U2#2.D11; also elsewhere on the board
/Boot/BT_CFG2[0]: U2#2.B11; also elsewhere on the board
/Boot/BT_CFG2[1]: U2#2.A11; also elsewhere on the board
/Boot/BT_CFG2[2]: U2#2.E12; also elsewhere on the board
/Boot/BT_CFG2[4]: U2#2.C12; also elsewhere on the board
/Boot/BT_CFG2[5]: U2#2.B12; also elsewhere on the board
/Boot/BT_CFG2[6]: U2#2.A12; also elsewhere on the board
/Boot/BT_CFG2[7]: U2#2.D13; also elsewhere on the board
/Boot/BT_CFG4[0]: U2#2.C13; also elsewhere on the board
/Boot/BT_CFG4[1]: U2#2.B13; also elsewhere on the board
/Boot/BT_CFG4[2]: U2#2.A13; also elsewhere on the board
/Boot/BT_CFG4[3]: U2#2.D14; also elsewhere on the board
/Boot/BT_CFG4[4]: U2#2.C14; also elsewhere on the board
/Boot/BT_CFG4[5]: U2#2.B14; also elsewhere on the board
/Boot/BT_CFG4[6]: U2#2.A14; also elsewhere on the board
/Boot/BT_CFG4[7]: U2#2.B16; also elsewhere on the board
/Crystals/BOOT_MODE0: U2#2.T10; also elsewhere on the board
/Crystals/BOOT_MODE1: U2#2.U10; also elsewhere on the board
/Crystals/JTAG_MOD: U2#2.P15; also elsewhere on the board
/Crystals/JTAG_TCK: U2#2.M14; also elsewhere on the board
/Crystals/JTAG_TDI: U2#2.N16; also elsewhere on the board
/Crystals/JTAG_TDO: U2#2.N15; also elsewhere on the board
/Crystals/JTAG_TMS: U2#2.P14; also elsewhere on the board
/Crystals/JTAG_nSRST: U2#2.P8; also elsewhere on the board
/Crystals/JTAG_nTRST: U2#2.N14; also elsewhere on the board
/Crystals/RTC_XTALI: U2#2.T11; also elsewhere on the board
/Crystals/RTC_XTALO: U2#2.U11; also elsewhere on the board
/Crystals/XTALI: U2#2.T16; also elsewhere on the board
/Crystals/XTALO: U2#2.T17; also elsewhere on the board
/DDR/DRAM_A0: U2#2.L5; also elsewhere on the board
/DDR/DRAM_A1: U2#2.H2; also elsewhere on the board
/DDR/DRAM_A2: U2#2.K1; also elsewhere on the board
/DDR/DRAM_A3: U2#2.M2; also elsewhere on the board
/DDR/DRAM_A4: U2#2.K4; also elsewhere on the board
/DDR/DRAM_A5: U2#2.L1; also elsewhere on the board
/DDR/DRAM_A6: U2#2.G2; also elsewhere on the board
/DDR/DRAM_A7: U2#2.H4; also elsewhere on the board
/DDR/DRAM_A8: U2#2.J4; also elsewhere on the board
/DDR/DRAM_A9: U2#2.L2; also elsewhere on the board
/DDR/DRAM_A10: U2#2.M4; also elsewhere on the board
/DDR/DRAM_A11: U2#2.K3; also elsewhere on the board
/DDR/DRAM_A12: U2#2.L4; also elsewhere on the board
/DDR/DRAM_A13: U2#2.H3; also elsewhere on the board
/DDR/DRAM_A14: U2#2.G1; also elsewhere on the board
/DDR/DRAM_A15: U2#2.K5; also elsewhere on the board
/DDR/DRAM_CAS_B: U2#2.J2; also elsewhere on the board
/DDR/DRAM_CS0_B: U2#2.N2; also elsewhere on the board
/DDR/DRAM_D0: U2#2.T4; also elsewhere on the board
/DDR/DRAM_D1: U2#2.U6; also elsewhere on the board
/DDR/DRAM_D2: U2#2.T6; also elsewhere on the board
/DDR/DRAM_D3: U2#2.U7; also elsewhere on the board
/DDR/DRAM_D4: U2#2.U8; also elsewhere on the board
/DDR/DRAM_D5: U2#2.T8; also elsewhere on the board
/DDR/DRAM_D6: U2#2.T5; also elsewhere on the board
/DDR/DRAM_D7: U2#2.U4; also elsewhere on the board
/DDR/DRAM_D8: U2#2.U2; also elsewhere on the board
/DDR/DRAM_D9: U2#2.U3; also elsewhere on the board
/DDR/DRAM_D10: U2#2.U5; also elsewhere on the board
/DDR/DRAM_D11: U2#2.R4; also elsewhere on the board
/DDR/DRAM_D12: U2#2.P5; also elsewhere on the board
/DDR/DRAM_D13: U2#2.P3; also elsewhere on the board
/DDR/DRAM_D14: U2#2.R2; also elsewhere on the board
/DDR/DRAM_D15: U2#2.R1; also elsewhere on the board
/DDR/DRAM_DQM0: U2#2.T7; also elsewhere on the board
/DDR/DRAM_DQM1: U2#2.T3; also elsewhere on the board
/DDR/DRAM_RAS_B: U2#2.M5; also elsewhere on the board
/DDR/DRAM_RESET_B: U2#2.G4; also elsewhere on the board
/DDR/DRAM_SDBA0: U2#2.M1; also elsewhere on the board
/DDR/DRAM_SDBA1: U2#2.H1; also elsewhere on the board
/DDR/DRAM_SDBA2: U2#2.K2; also elsewhere on the board
/DDR/DRAM_SDCKE0: U2#2.M3; also elsewhere on the board
/DDR/DRAM_SDCLK0_N: U2#2.P2; also elsewhere on the board
/DDR/DRAM_SDCLK0_P: U2#2.P1; also elsewhere on the board
/DDR/DRAM_SDODT0: U2#2.N1; also elsewhere on the board
/DDR/DRAM_SDQS0_N: U2#2.P7; also elsewhere on the board
/DDR/DRAM_SDQS0_P: U2#2.P6; also elsewhere on the board
/DDR/DRAM_SDQS1_N: U2#2.T2; also elsewhere on the board
/DDR/DRAM_SDQS1_P: U2#2.T1; also elsewhere on the board
/DDR/DRAM_WE_B: U2#2.J1; also elsewhere on the board
/DDR/DRAM_ZQPAD: U2#2.N4; also elsewhere on the board
/Power/NVCC_PLL_OUT: U2#2.P13; also elsewhere on the board
/Power/VDD_ARM_CAP: U2#2.G9, U2#2.G10, U2#2.G11, U2#2.H11; also elsewhere on the board
/Power/VDD_SNVS_CAP: U2#2.N12; also elsewhere on the board
/Power/VDD_SOC_CAP: U2#2.G8, U2#2.H8, U2#2.J8, U2#2.J11, U2#2.K8, U2#2.K11, U2#2.L8, U2#2.L9, U2#2.L10, U2#2.L11; also elsewhere on the board
/USB/USB1_DN: U2#2.T15; also elsewhere on the board
/USB/USB1_DP: U2#2.U15; also elsewhere on the board
/USB/VDD_USB_CAP: U2#2.R12; also elsewhere on the board
/eMMC/SD2_CLK_R: U2#2.D8; also elsewhere on the board
/eMMC/SD2_CMD: U2#2.C8; also elsewhere on the board
/eMMC/SD2_DATA0: U2#2.D7; also elsewhere on the board
/eMMC/SD2_DATA1: U2#2.B7; also elsewhere on the board
/eMMC/SD2_DATA2: U2#2.A7; also elsewhere on the board
/eMMC/SD2_DATA3: U2#2.D6; also elsewhere on the board
/eMMC/SD2_DATA4: U2#2.C6; also elsewhere on the board
/eMMC/SD2_DATA5: U2#2.B6; also elsewhere on the board
/eMMC/SD2_DATA6: U2#2.A6; also elsewhere on the board
/eMMC/SD2_DATA7: U2#2.A5; also elsewhere on the board
/eMMC/SD2_RESET_B: U2#2.B4; also elsewhere on the board
A71CH_RESET: U2#2.A16; also elsewhere on the board
Amb_sensor_INT: U2#2.M17; also elsewhere on the board
DCDC_3V3: U2#2.C4, U2#2.E13, U2#2.F4, U2#2.F13, U2#2.H13, U2#2.J13; also elsewhere on the board
DDR_1V35: U2#2.G6, U2#2.H6, U2#2.J6, U2#2.K6, U2#2.L6, U2#2.M6; also elsewhere on the board
DDR_VREF: U2#2.P4; also elsewhere on the board
GND: U2#2.A1, U2#2.A17, U2#2.C3, U2#2.C7, U2#2.C11, U2#2.C15, U2#2.E8, U2#2.E11, U2#2.F6, U2#2.F7, U2#2.F8, U2#2.F9, U2#2.F10, U2#2.F11, U2#2.F12, U2#2.G3, U2#2.G5, U2#2.G7, U2#2.G12, U2#2.G15, U2#2.H7, U2#2.H12, U2#2.J5, U2#2.J7, U2#2.J12, U2#2.K7, U2#2.K12, U2#2.L3, U2#2.L7, U2#2.L12, U2#2.M7, U2#2.M8, U2#2.M9, U2#2.M10, U2#2.M11, U2#2.M12, U2#2.N3, U2#2.N5, U2#2.N7, U2#2.R3, U2#2.R5, U2#2.R7, U2#2.R11, U2#2.R16, U2#2.R17, U2#2.T14, U2#2.U1, U2#2.U14, U2#2.U17; also elsewhere on the board
GPIO1_IO25: U2#2.H15; also elsewhere on the board
GPIO1_IO27: U2#2.G14; also elsewhere on the board
GPS_PIO14: U2#2.D16; also elsewhere on the board
GPS_RESET: U2#2.C16; also elsewhere on the board
GPS_SAFEBOOT_N: U2#2.D17; also elsewhere on the board
GPS_UART_RX: U2#2.H16; also elsewhere on the board
GPS_UART_TX: U2#2.H17; also elsewhere on the board
I2C1_SCL: U2#2.L14; also elsewhere on the board
I2C1_SDA: U2#2.L17; also elsewhere on the board
I2C2_SCL: U2#2.F17; also elsewhere on the board
I2C2_SDA: U2#2.G13; also elsewhere on the board
ICS43434_SCK: U2#2.E1; also elsewhere on the board
ICS43434_SD: U2#2.D2; also elsewhere on the board
ICS43434_WS: U2#2.E2; also elsewhere on the board
LDO2_3V3: U2#2.L13, U2#2.M13, U2#2.N13, U2#2.P12; also elsewhere on the board
MPU6K_INT: U2#2.L15; also elsewhere on the board
NVCC_NAND: U2#2.E7; also elsewhere on the board
unnamed 172: U2#2.E4; also elsewhere on the board
unnamed 173: U2#2.E3; also elsewhere on the board
unnamed 174: U2#2.A2; also elsewhere on the board
unnamed 175: U2#2.A3; also elsewhere on the board
unnamed 176: U2#2.A4; also elsewhere on the board
unnamed 177: U2#2.A8; also elsewhere on the board
unnamed 178: U2#2.A15; also elsewhere on the board
unnamed 179: U2#2.B1; also elsewhere on the board
unnamed 180: U2#2.B2; also elsewhere on the board
unnamed 181: U2#2.B3; also elsewhere on the board
unnamed 182: U2#2.B5; also elsewhere on the board
unnamed 183: U2#2.B8; also elsewhere on the board
unnamed 184: U2#2.B15; also elsewhere on the board
unnamed 185: U2#2.C1; also elsewhere on the board
unnamed 186: U2#2.C2; also elsewhere on the board
unnamed 187: U2#2.C5; also elsewhere on the board
unnamed 188: U2#2.C9; also elsewhere on the board
unnamed 189: U2#2.D1; also elsewhere on the board
unnamed 190: U2#2.D3; also elsewhere on the board
unnamed 191: U2#2.D4; also elsewhere on the board
unnamed 192: U2#2.D5; also elsewhere on the board
unnamed 193: U2#2.D9; also elsewhere on the board
unnamed 194: U2#2.D15; also elsewhere on the board
unnamed 195: U2#2.E5; also elsewhere on the board
unnamed 196: U2#2.E6; also elsewhere on the board
unnamed 197: U2#2.E9; also elsewhere on the board
unnamed 198: U2#2.E14; also elsewhere on the board
unnamed 199: U2#2.E15; also elsewhere on the board
unnamed 200: U2#2.E16; also elsewhere on the board
unnamed 201: U2#2.E17; also elsewhere on the board
unnamed 202: U2#2.F1; also elsewhere on the board
unnamed 203: U2#2.F2; also elsewhere on the board
unnamed 204: U2#2.F3; also elsewhere on the board
unnamed 205: U2#2.F5; also elsewhere on the board
unnamed 206: U2#2.F14; also elsewhere on the board
unnamed 207: U2#2.F16; also elsewhere on the board
unnamed 208: U2#2.H5; also elsewhere on the board
unnamed 209: U2#2.H14; also elsewhere on the board
unnamed 210: U2#2.J3; also elsewhere on the board
unnamed 211: U2#2.J14; also elsewhere on the board
unnamed 212: U2#2.J15; also elsewhere on the board
unnamed 213: U2#2.J16; also elsewhere on the board
unnamed 214: U2#2.J17; also elsewhere on the board
unnamed 215: U2#2.K14; also elsewhere on the board
unnamed 216: U2#2.K15; also elsewhere on the board
unnamed 217: U2#2.K16; also elsewhere on the board
unnamed 218: U2#2.N8; also elsewhere on the board
unnamed 219: U2#2.N9; also elsewhere on the board
unnamed 220: U2#2.N10; also elsewhere on the board
unnamed 221: U2#2.N11; also elsewhere on the board
unnamed 222: U2#2.P9; also elsewhere on the board
unnamed 223: U2#2.P10; also elsewhere on the board
unnamed 224: U2#2.P11; also elsewhere on the board
unnamed 225: U2#2.P16; also elsewhere on the board
unnamed 226: U2#2.P17; also elsewhere on the board
unnamed 227: U2#2.R6; also elsewhere on the board
unnamed 228: U2#2.R8; also elsewhere on the board
unnamed 229: U2#2.R9; also elsewhere on the board
unnamed 230: U2#2.R10; also elsewhere on the board
unnamed 231: U2#2.R13; also elsewhere on the board
unnamed 232: U2#2.T9; also elsewhere on the board
unnamed 233: U2#2.T13; also elsewhere on the board
unnamed 234: U2#2.U9; also elsewhere on the board
unnamed 235: U2#2.U12; also elsewhere on the board
unnamed 236: U2#2.U13; also elsewhere on the board
unnamed 237: U2#2.U16; also elsewhere on the board
PMIC_WDI: U2#2.F15; also elsewhere on the board
SE1_LED: U2#2.M15; also elsewhere on the board
SE2_LED: U2#2.N17; also elsewhere on the board
SE3_LED: U2#2.L16; also elsewhere on the board
SE4_LED: U2#2.K17; also elsewhere on the board
SE5_LED: U2#2.M16; also elsewhere on the board
SLS32A_RESET: U2#2.C17; also elsewhere on the board
UART4_RX: U2#2.G16; also elsewhere on the board
UART4_TX: U2#2.G17; also elsewhere on the board
USB1_INT_B: U2#2.K13; also elsewhere on the board
VDD_ARM_SOC_IN: U2#2.H9, U2#2.H10, U2#2.J9, U2#2.J10, U2#2.K9, U2#2.K10; also elsewhere on the board
VDD_HIGH_CAP: U2#2.N6, U2#2.R14, U2#2.R15; also elsewhere on the board
VSYS_5V: U2#2.T12; also elsewhere on the board
eCompass_INT: U2#2.B17; also elsewhere on the board
