FranciscoVentures/EN7745/(notices)

Notices in the files:
Hardware/Curiosity.sch:
Copyright © 2019 F-Secure
License: CERN OHL v1.2
Hardware/Curiosity.kicad_pcb:
Copyright © Francisco Ventures
parts and their libraries:
Copyright 2016 Accelerated Designs. All rights reserved.
